Nate-Asmare/Quadruple-robot-build-and-design/images/hardware/IMG_2756.JPG

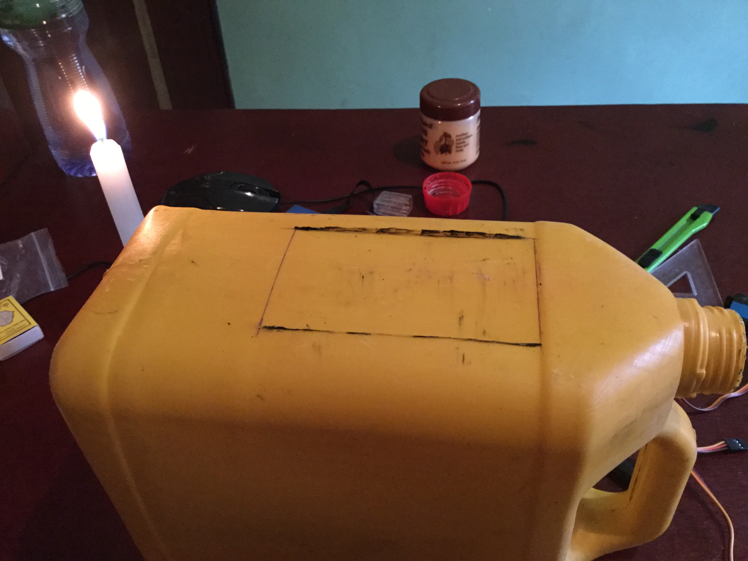
images/hardware/IMG_2756.JPG
