Nate-Asmare/Quadruple-robot-build-and-design/images/ado/Untitled-1.png

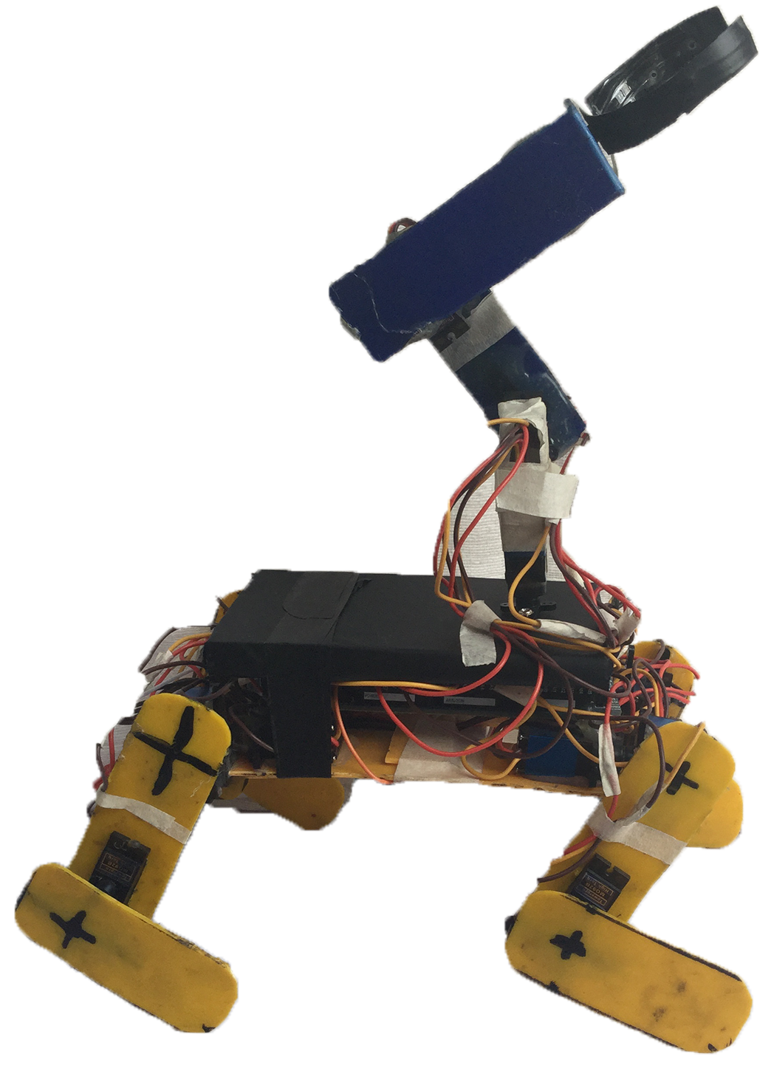
images/ado/Untitled-1.png
