Nate-Asmare/Quadruple-robot-build-and-design/images/design/photo_2020-02-02_10-24-55.jpg

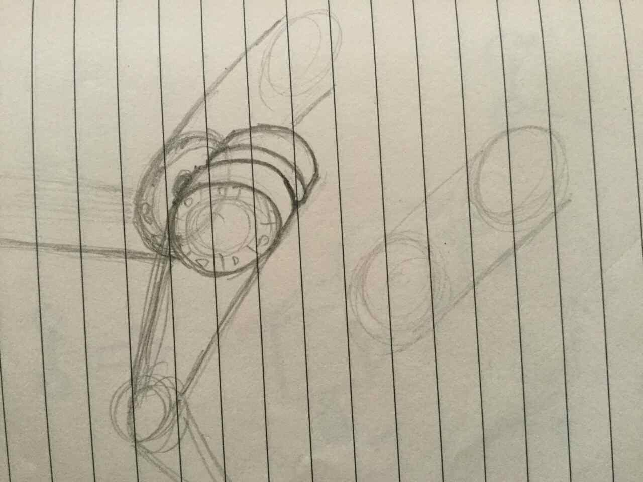
images/design/photo_2020-02-02_10-24-55.jpg
