Nate-Asmare/Quadruple-robot-build-and-design/images/design/photo_2020-02-02_10-25-00.jpg

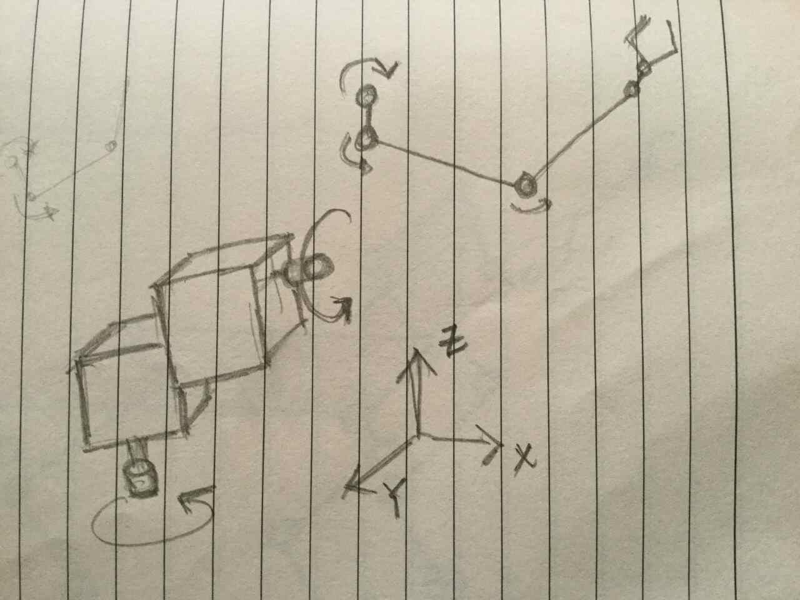
images/design/photo_2020-02-02_10-25-00.jpg
