Nate-Asmare/Quadruple-robot-build-and-design/images/diagrams and sketches/22.png

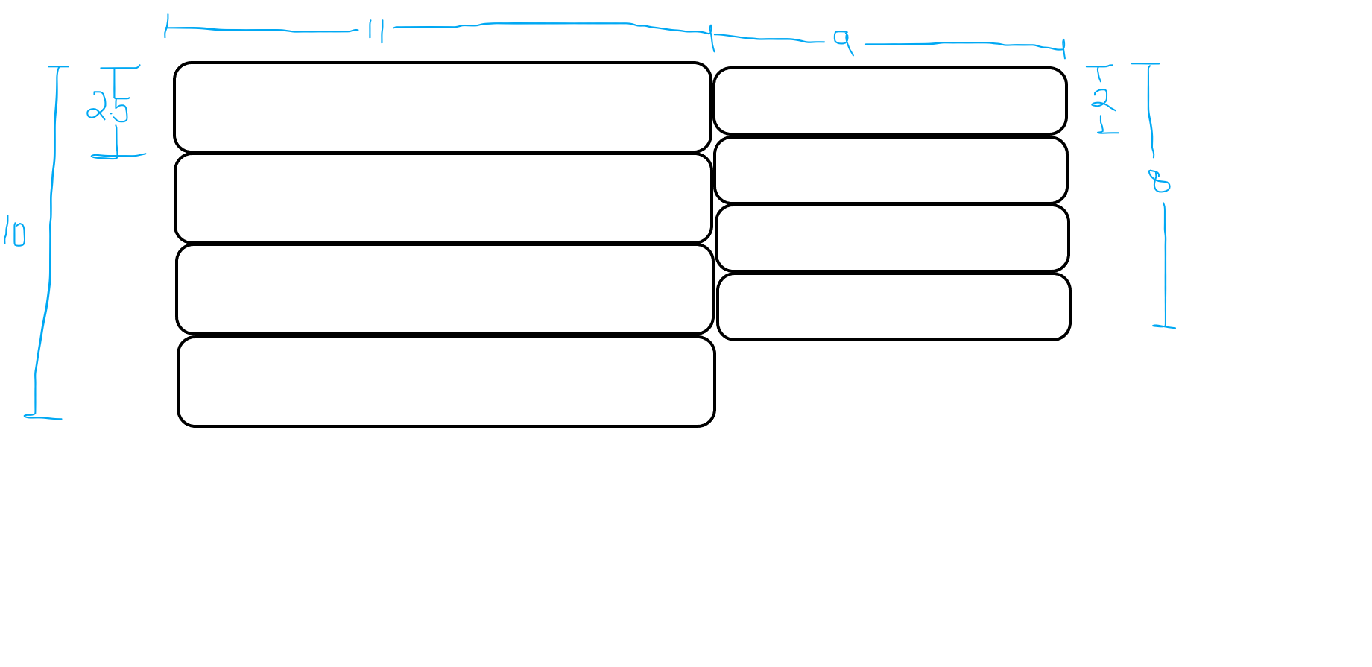
images/diagrams and sketches/22.png
