Nate-Asmare/Quadruple-robot-build-and-design/images/diagrams and sketches/arm bare model.png

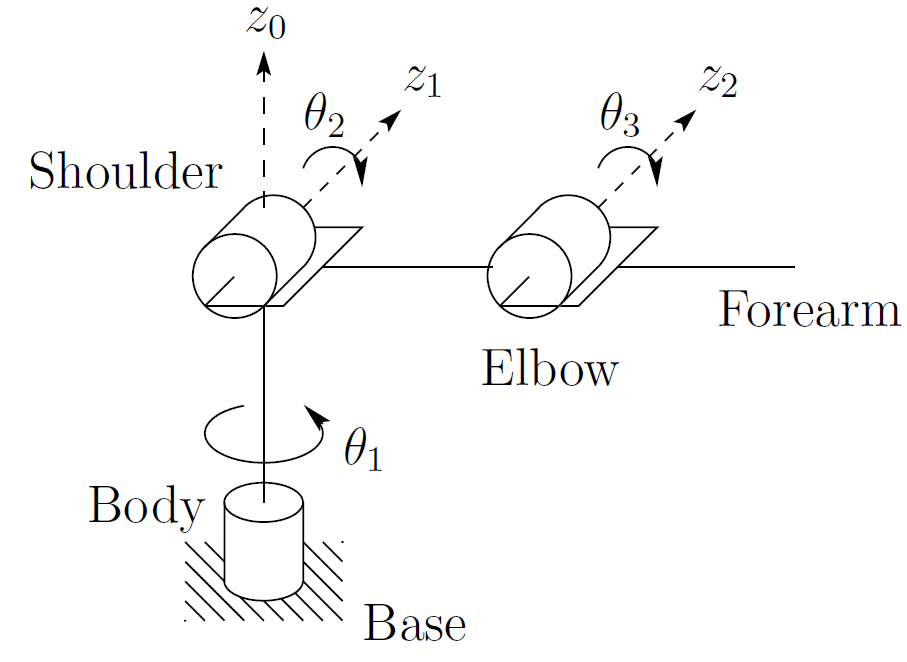
images/diagrams and sketches/arm bare model.png
