Nate-Asmare/Quadruple-robot-build-and-design/images/diagrams and sketches/arm dimentions2.png

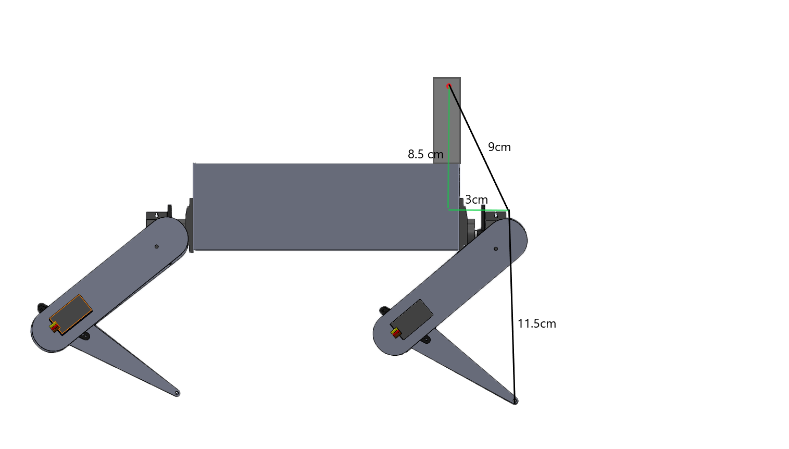
images/diagrams and sketches/arm dimentions2.png
