Nate-Asmare/Quadruple-robot-build-and-design/images/diagrams and sketches/arm dimentions.png

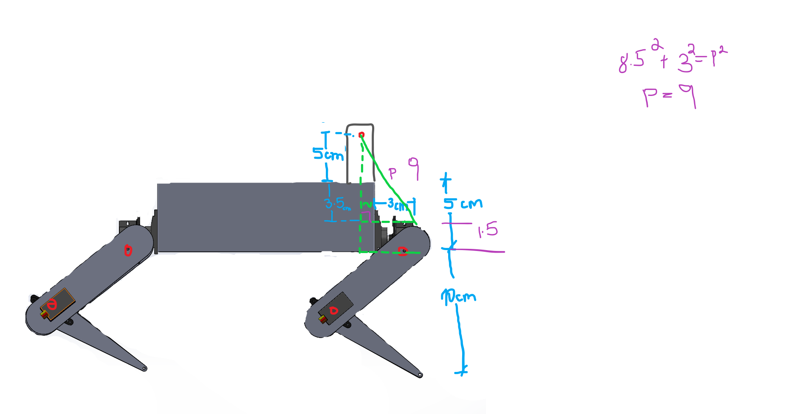
images/diagrams and sketches/arm dimentions.png
