Nate-Asmare/Quadruple-robot-build-and-design/images/diagrams and sketches/big quadrupled locomotive.png

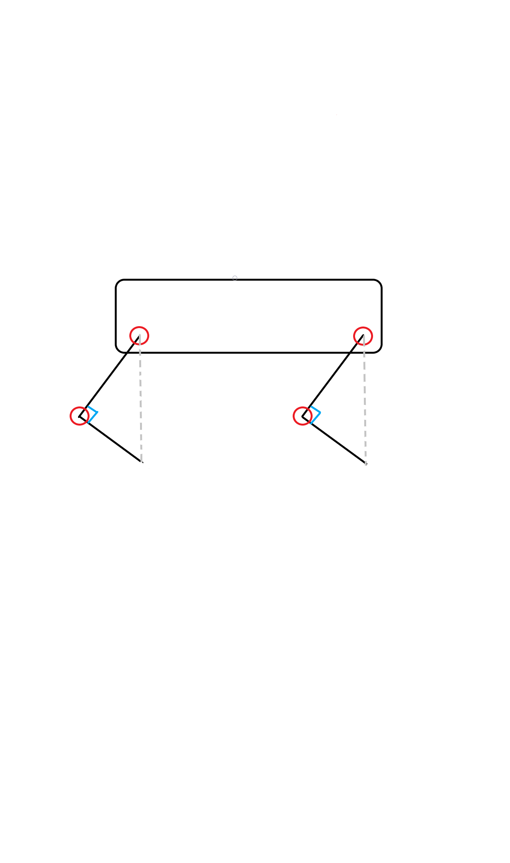
images/diagrams and sketches/big quadrupled locomotive.png
