Nate-Asmare/Quadruple-robot-build-and-design/images/diagrams and sketches/controler design.png

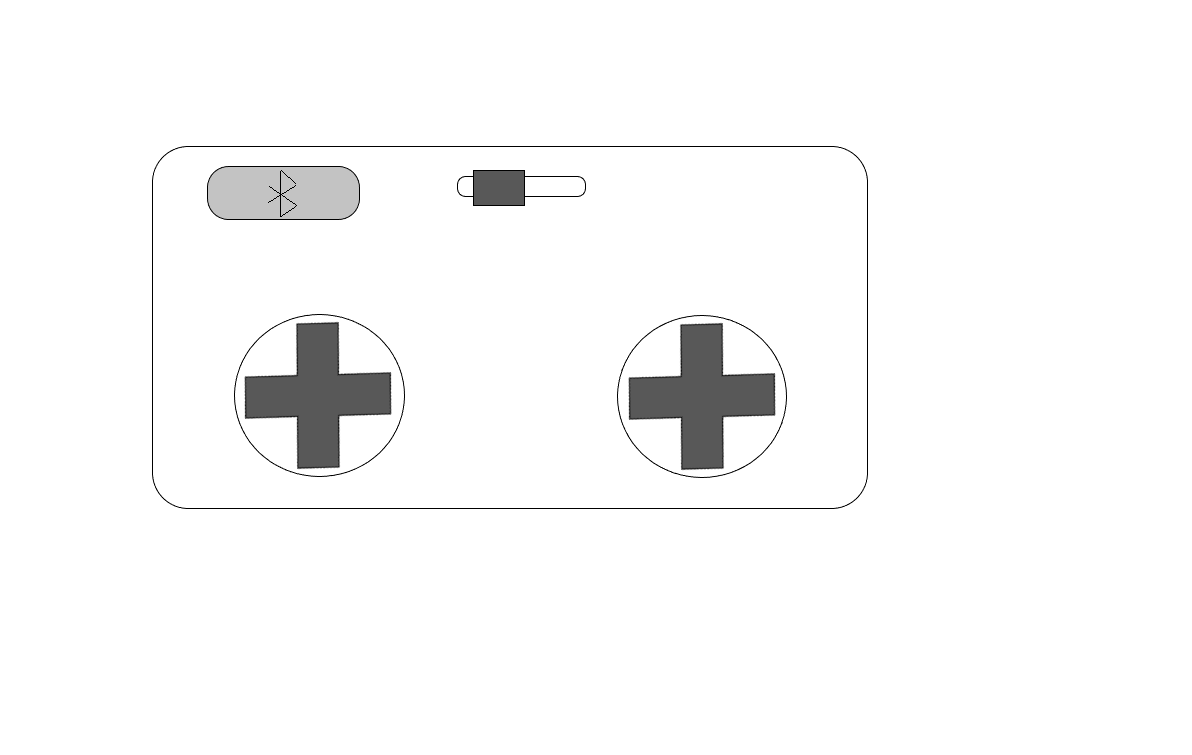
images/diagrams and sketches/controler design.png
