Nate-Asmare/Quadruple-robot-build-and-design/images/diagrams and sketches/cup.png

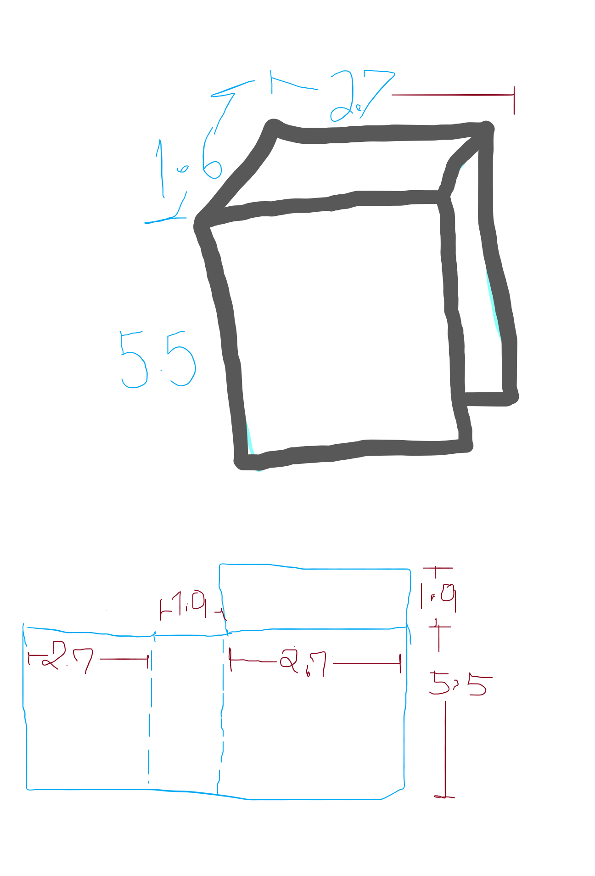
images/diagrams and sketches/cup.png
