Nate-Asmare/Quadruple-robot-build-and-design/images/diagrams and sketches/elbow down final.png

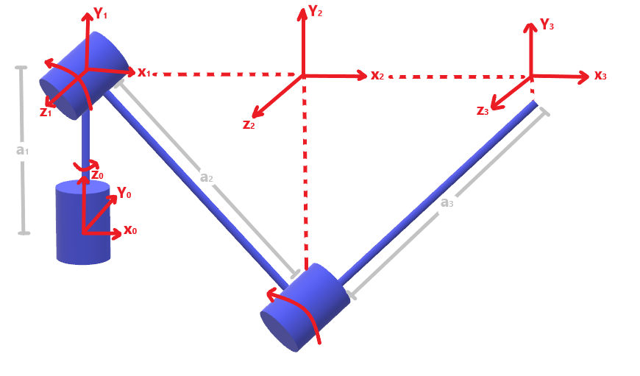
images/diagrams and sketches/elbow down final.png
