Nate-Asmare/Quadruple-robot-build-and-design/images/diagrams and sketches/elbow down.PNG

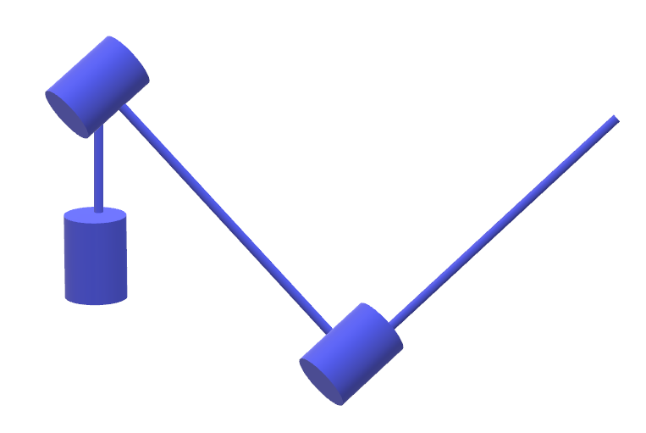
images/diagrams and sketches/elbow down.PNG
