Nate-Asmare/Quadruple-robot-build-and-design/images/diagrams and sketches/end effector.png

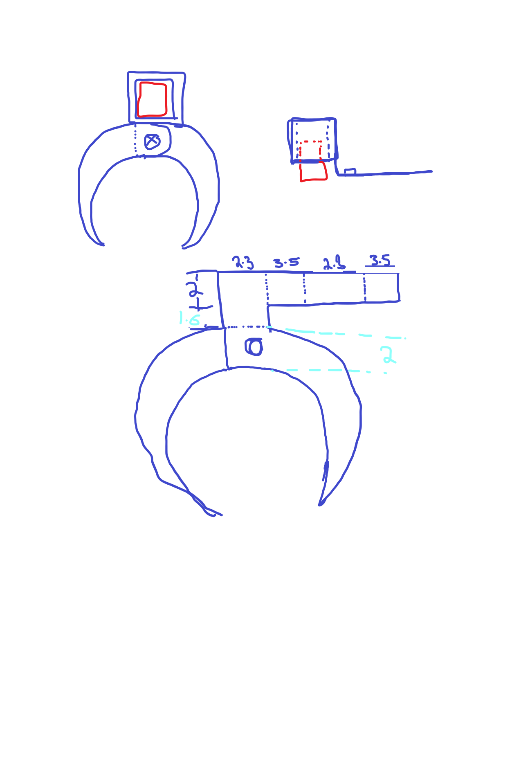
images/diagrams and sketches/end effector.png
