Nate-Asmare/Quadruple-robot-build-and-design/images/diagrams and sketches/flat on ground.png

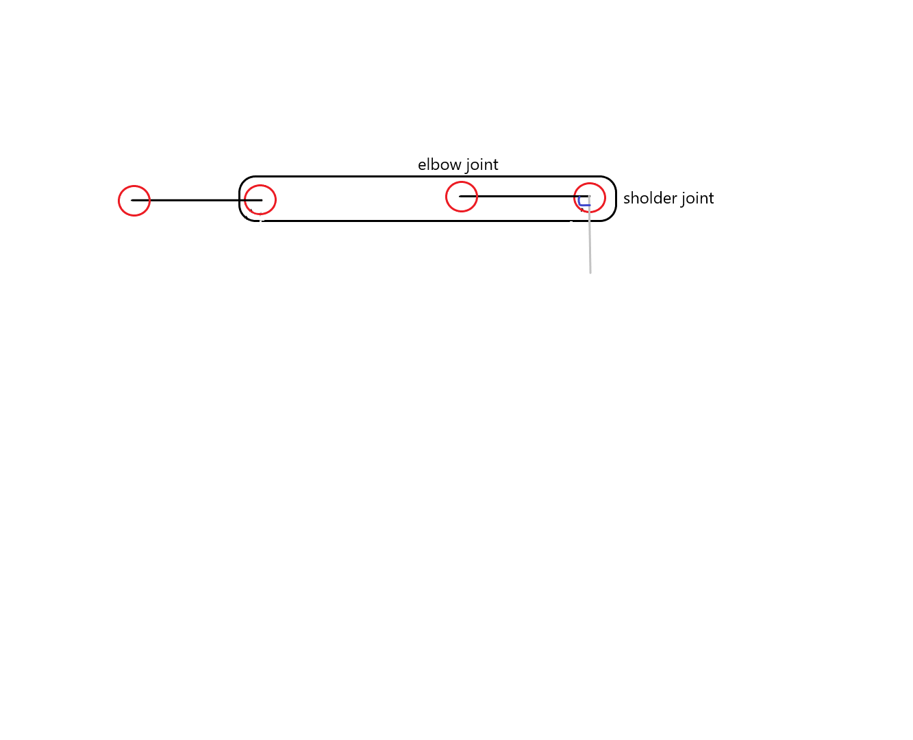
images/diagrams and sketches/flat on ground.png
