Nate-Asmare/Quadruple-robot-build-and-design/images/diagrams and sketches/for torque calculation.png

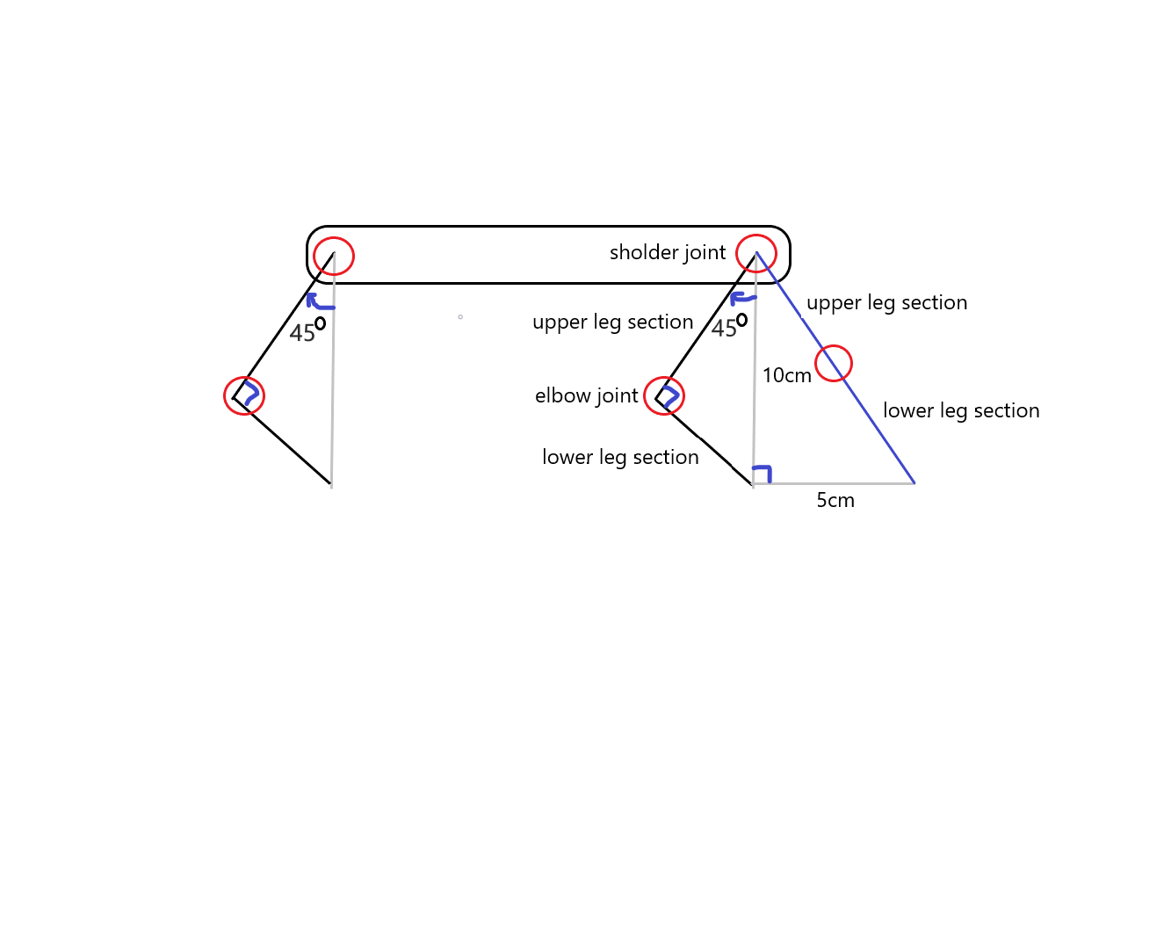
images/diagrams and sketches/for torque calculation.png
