Nate-Asmare/Quadruple-robot-build-and-design/images/diagrams and sketches/going stright gait.png

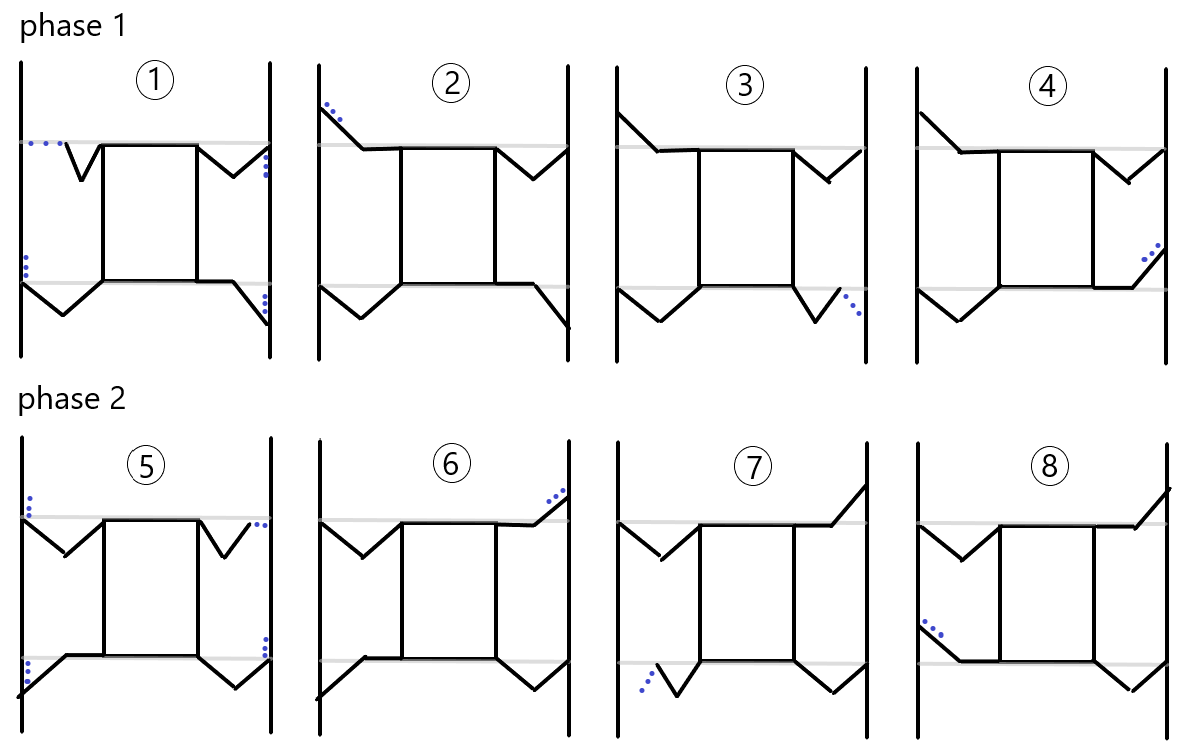
images/diagrams and sketches/going stright gait.png
