Nate-Asmare/Quadruple-robot-build-and-design/images/diagrams and sketches/kinematic model for quadruple locomotive.png

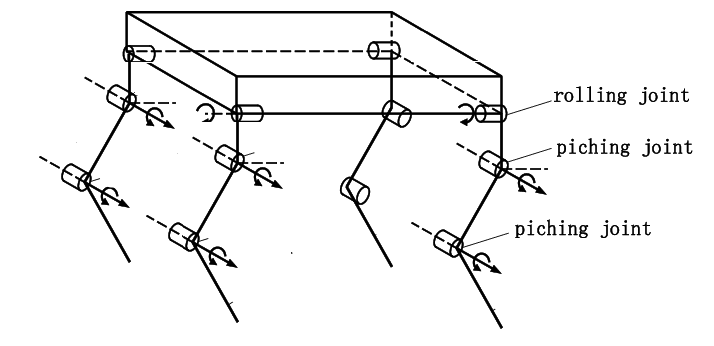
images/diagrams and sketches/kinematic model for quadruple locomotive.png
