Nate-Asmare/Quadruple-robot-build-and-design/images/diagrams and sketches/leg design sketch.png

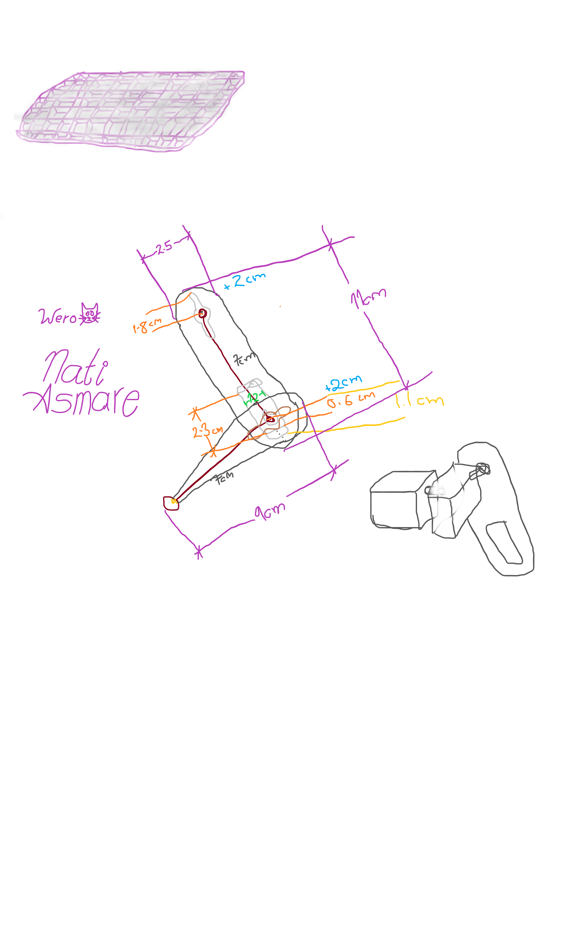
images/diagrams and sketches/leg design sketch.png
