Nate-Asmare/Quadruple-robot-build-and-design/images/diagrams and sketches/leg section calculation.png

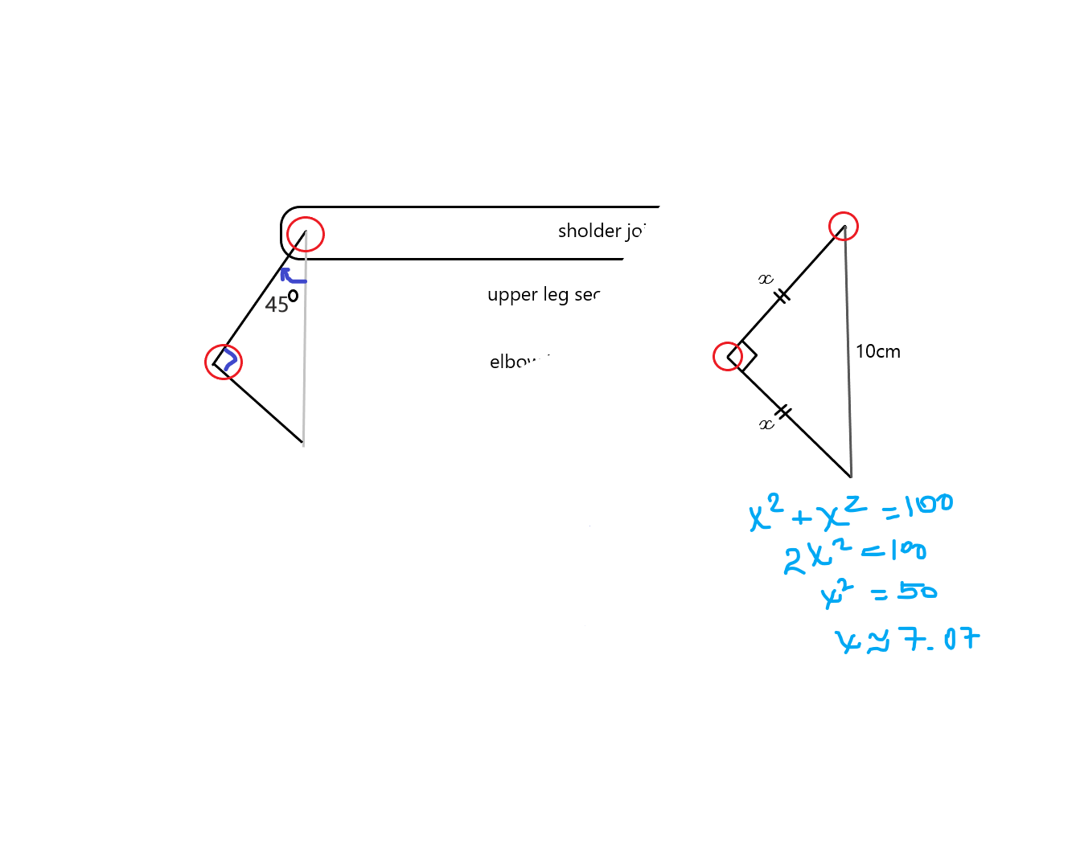
images/diagrams and sketches/leg section calculation.png
