Nate-Asmare/Quadruple-robot-build-and-design/images/diagrams and sketches/Maximum hight form of quadrupled robot.png

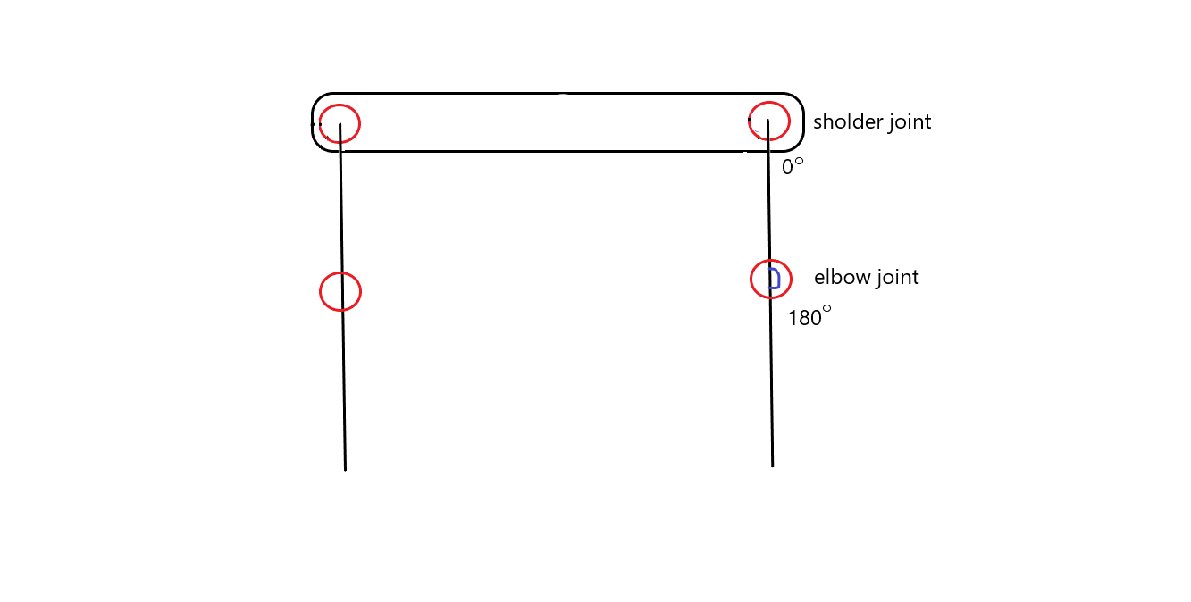
images/diagrams and sketches/Maximum hight form of quadrupled robot.png
