Nate-Asmare/Quadruple-robot-build-and-design/images/diagrams and sketches/quadrupled locomotive default form sketch 1.png

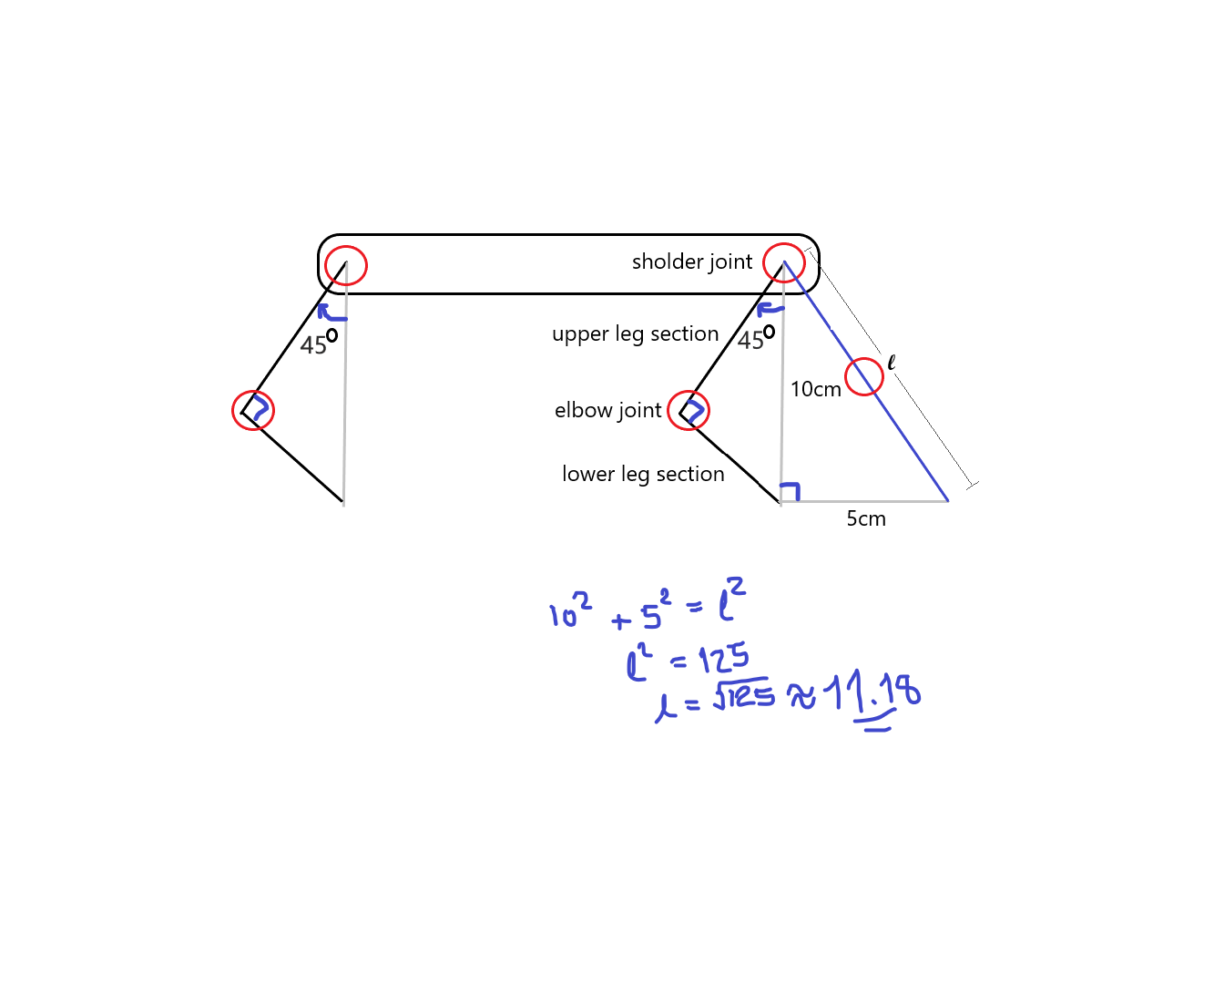
images/diagrams and sketches/quadrupled locomotive default form sketch 1.png
