Nate-Asmare/Quadruple-robot-build-and-design/images/diagrams and sketches/quadrupled locomotive side view.PNG

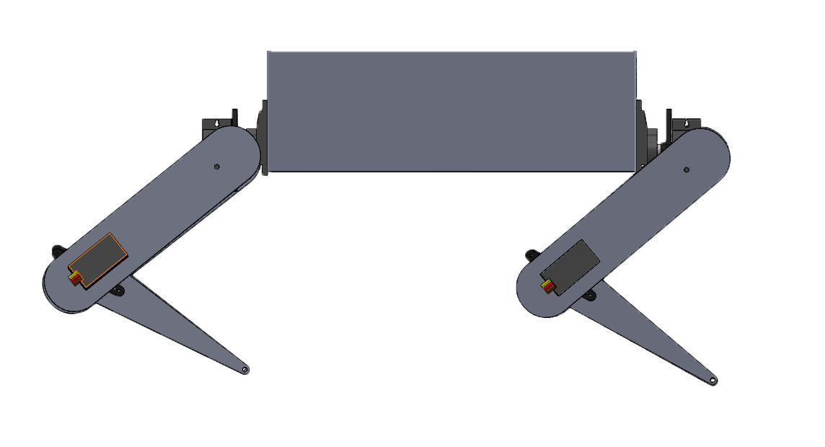
images/diagrams and sketches/quadrupled locomotive side view.PNG
