Nate-Asmare/Quadruple-robot-build-and-design/images/diagrams and sketches/top and side kenimatic view elbow up.png

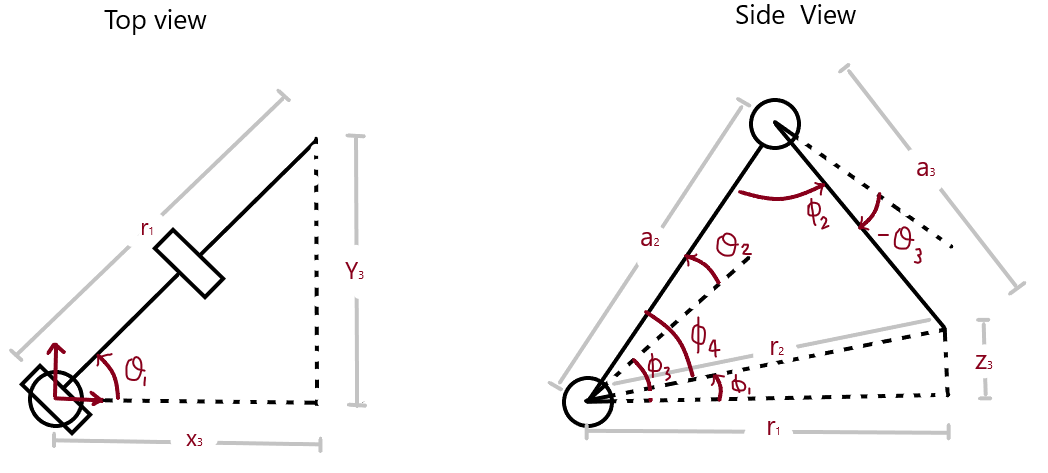
images/diagrams and sketches/top and side kenimatic view elbow up.png
