Nate-Asmare/Quadruple-robot-build-and-design/images/diagrams and sketches/torque calculation model.png

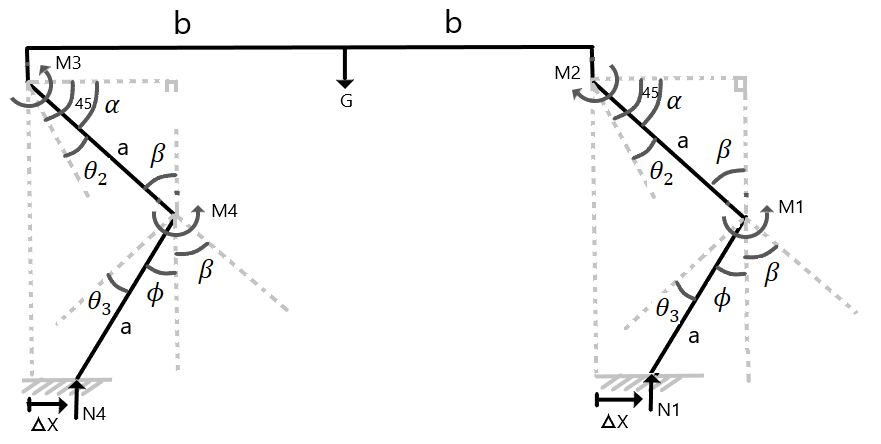
images/diagrams and sketches/torque calculation model.png
