Nate-Asmare/Quadruple-robot-build-and-design/images/diagrams and sketches/turning base.png

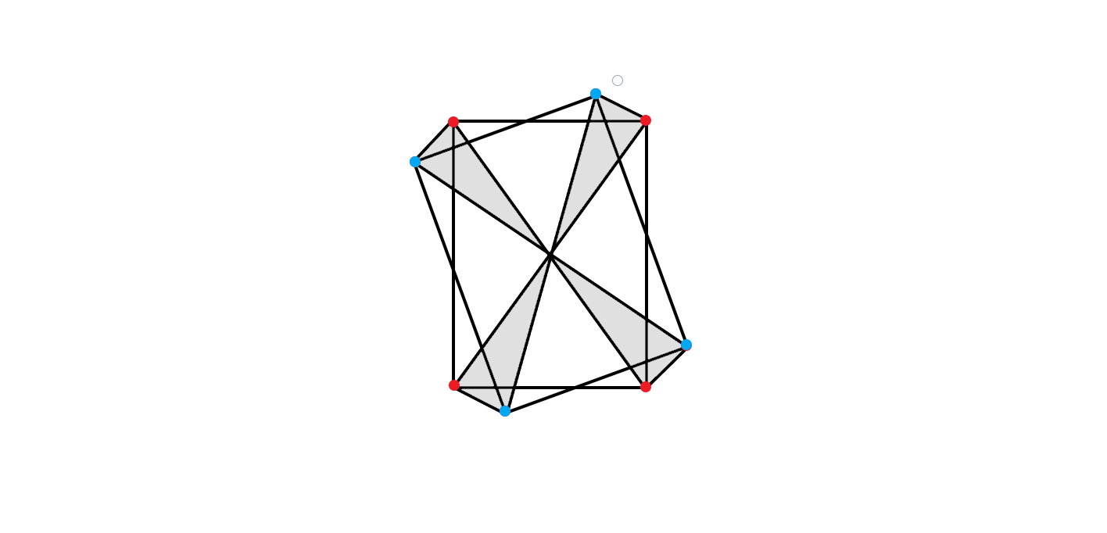
images/diagrams and sketches/turning base.png
