Nate-Asmare/Quadruple-robot-build-and-design/images/diagrams and sketches/turning gait model.png

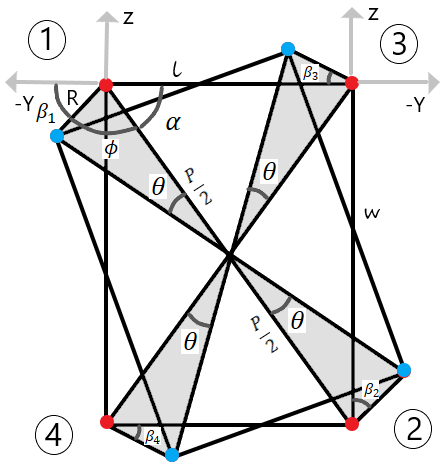
images/diagrams and sketches/turning gait model.png
