Nate-Asmare/Quadruple-robot-build-and-design/images/drawings/9v battery.PNG

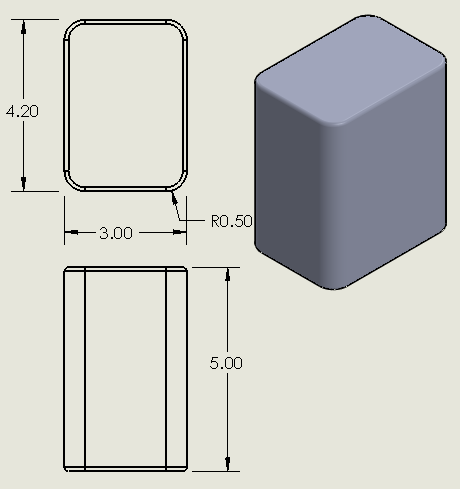
images/drawings/9v battery.PNG
