Nate-Asmare/Quadruple-robot-build-and-design/images/drawings/arduino with sheild.PNG

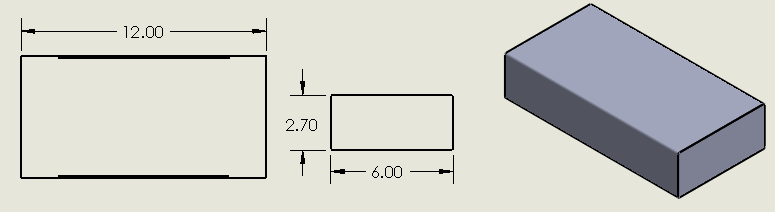
images/drawings/arduino with sheild.PNG
