Nate-Asmare/Quadruple-robot-build-and-design/images/drawings/body enclosure drowing.PNG

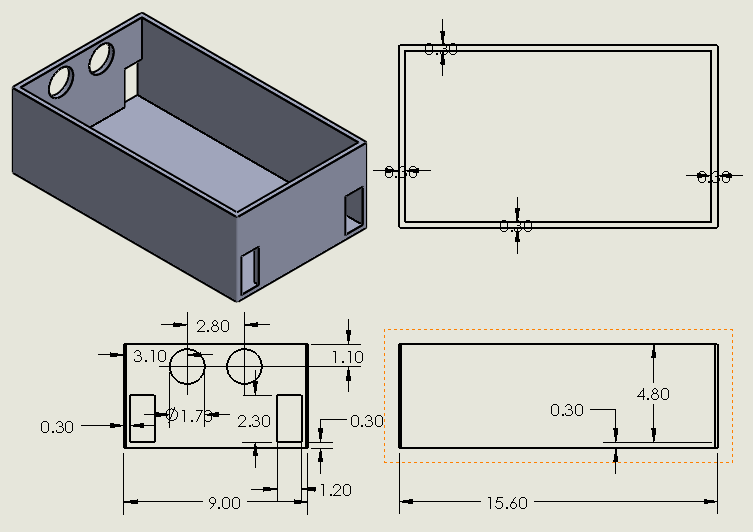
images/drawings/body enclosure drowing.PNG
