Nate-Asmare/Quadruple-robot-build-and-design/images/drawings/lower leg section.PNG

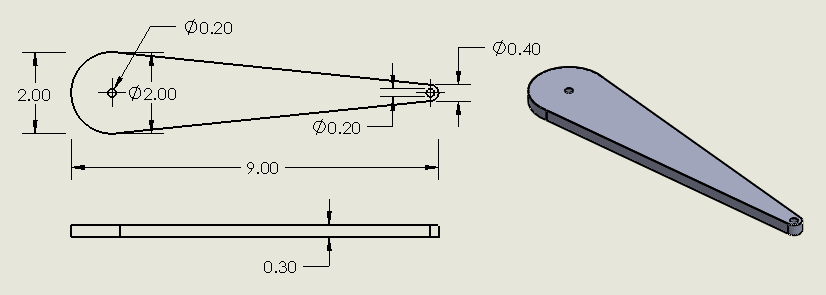
images/drawings/lower leg section.PNG
