Nate-Asmare/Quadruple-robot-build-and-design/images/drawings/quadruple locomotive mode.png

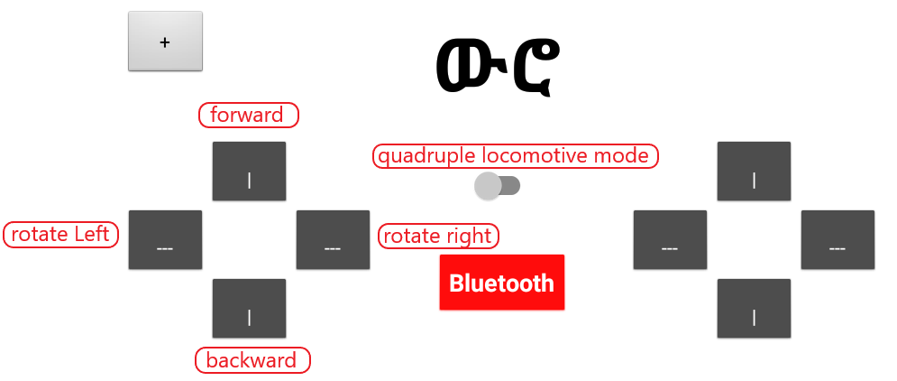
images/drawings/quadruple locomotive mode.png
