Nate-Asmare/Quadruple-robot-build-and-design/images/drawings/quadrupled locomotive 3 view.PNG

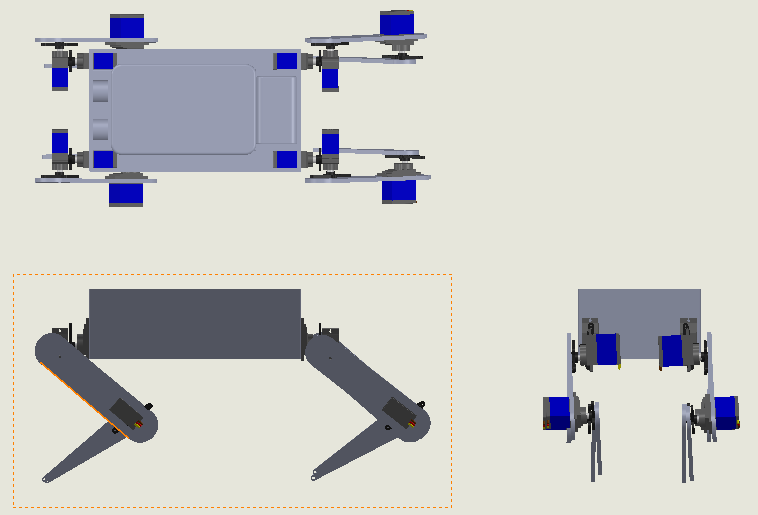
images/drawings/quadrupled locomotive 3 view.PNG
