Nate-Asmare/Quadruple-robot-build-and-design/images/drawings/quadrupled locomotive hight.PNG

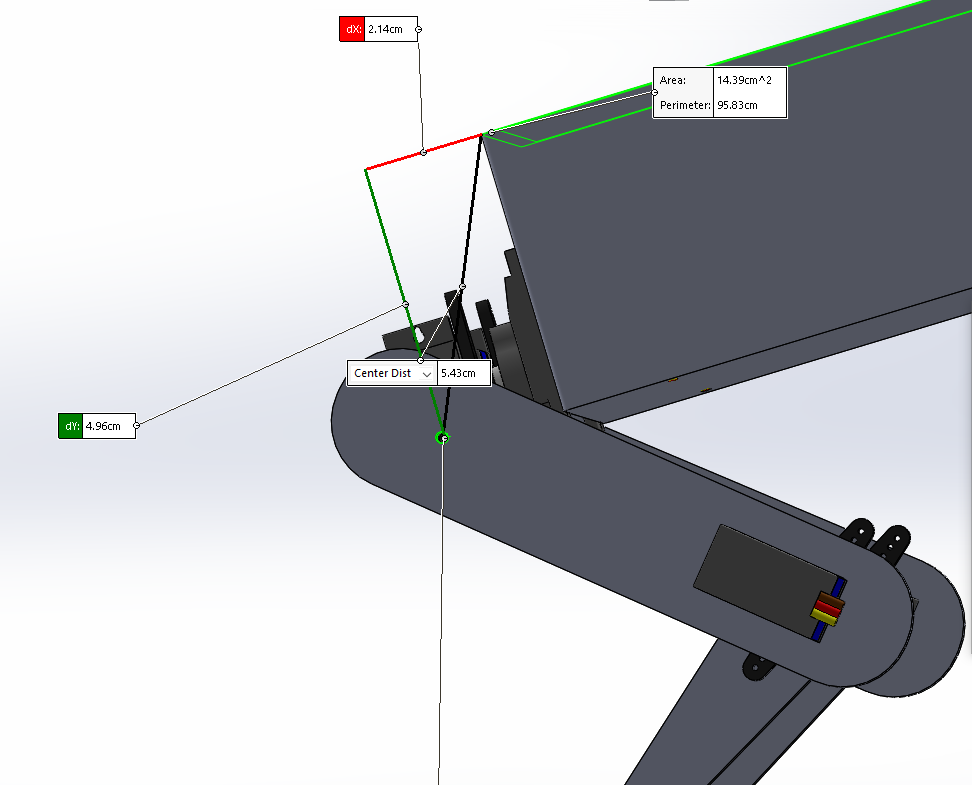
images/drawings/quadrupled locomotive hight.PNG
