Nate-Asmare/Quadruple-robot-build-and-design/images/drawings/quadrupled locomotive.PNG

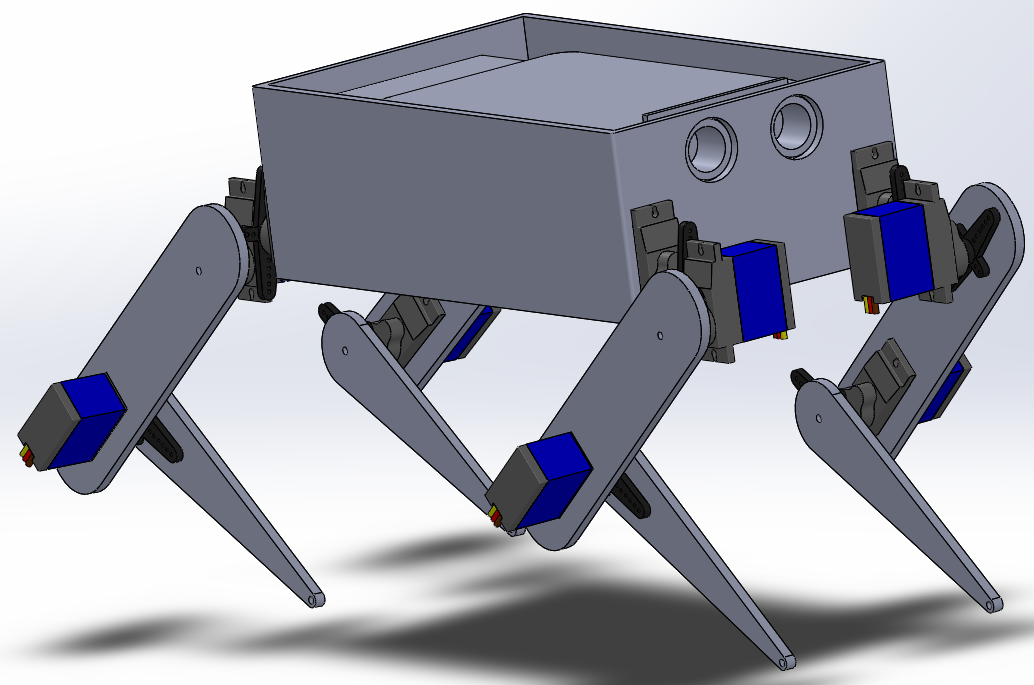
images/drawings/quadrupled locomotive.PNG
