Nate-Asmare/Quadruple-robot-build-and-design/images/drawings/robotic arm control.png

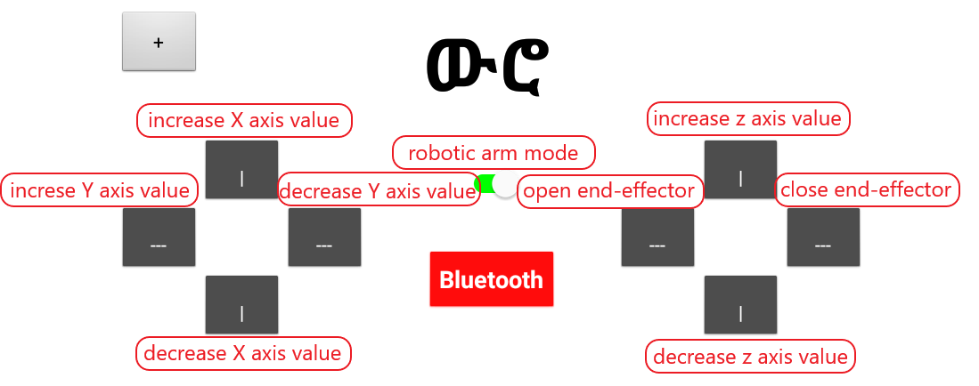
images/drawings/robotic arm control.png
