Nate-Asmare/Quadruple-robot-build-and-design/images/drawings/ultrasonic sensor.PNG

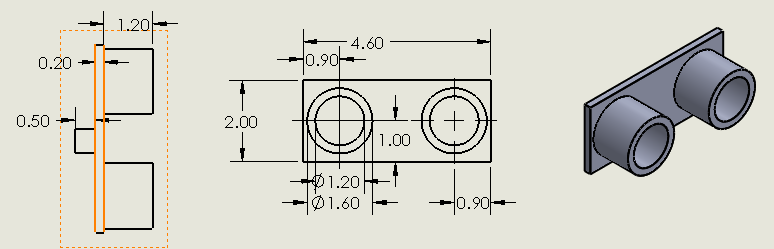
images/drawings/ultrasonic sensor.PNG
