Nate-Asmare/Quadruple-robot-build-and-design/images/drawings/upper leg section.PNG

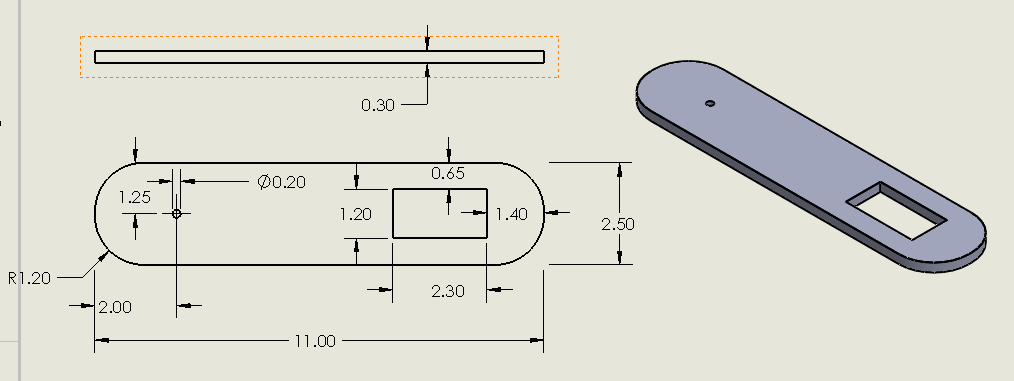
images/drawings/upper leg section.PNG
