Nate-Asmare/Quadruple-robot-build-and-design/images/drawings/workspace of arm.PNG

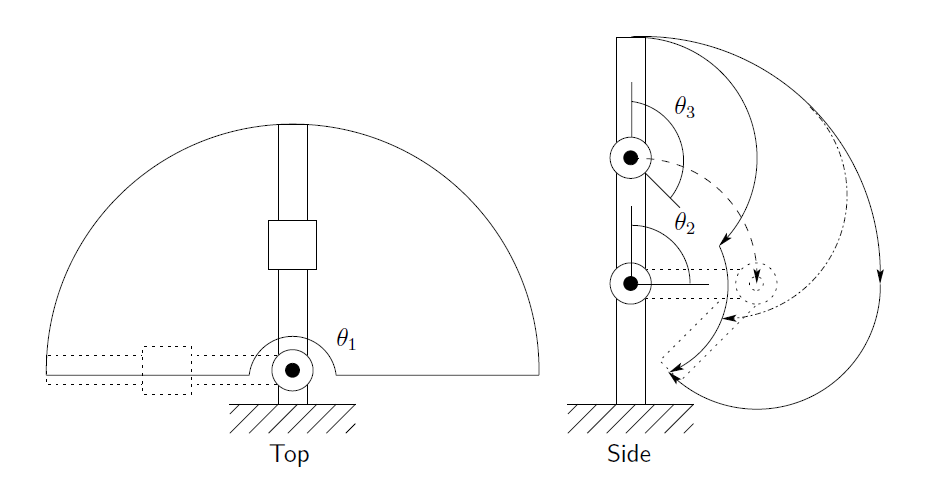
images/drawings/workspace of arm.PNG
