Nate-Asmare/Quadruple-robot-build-and-design/images/for kinematics/The-Schematic-Diagram-of-the-Quadruped-Robot.png

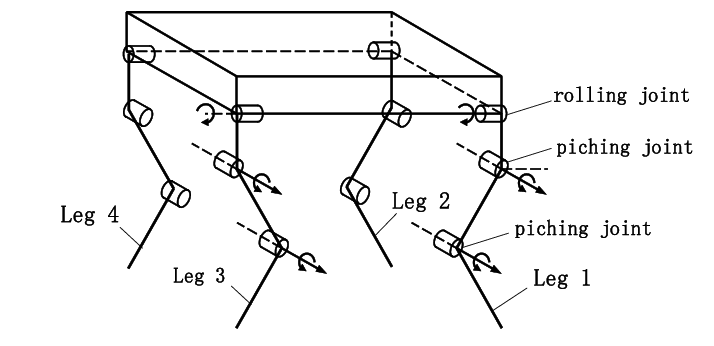
images/for kinematics/The-Schematic-Diagram-of-the-Quadruped-Robot.png
