Nate-Asmare/Quadruple-robot-build-and-design/images/hardware/IMG_2757.JPG

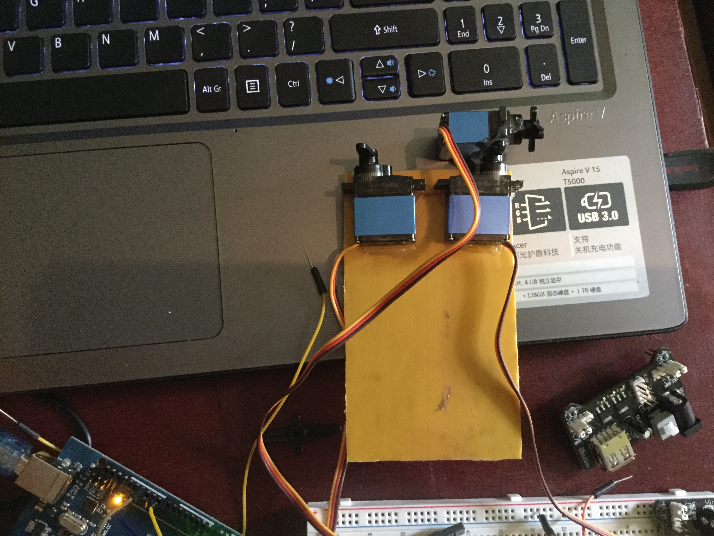
images/hardware/IMG_2757.JPG
