Nate-Asmare/Quadruple-robot-build-and-design/images/hardware/IMG_2758.JPG

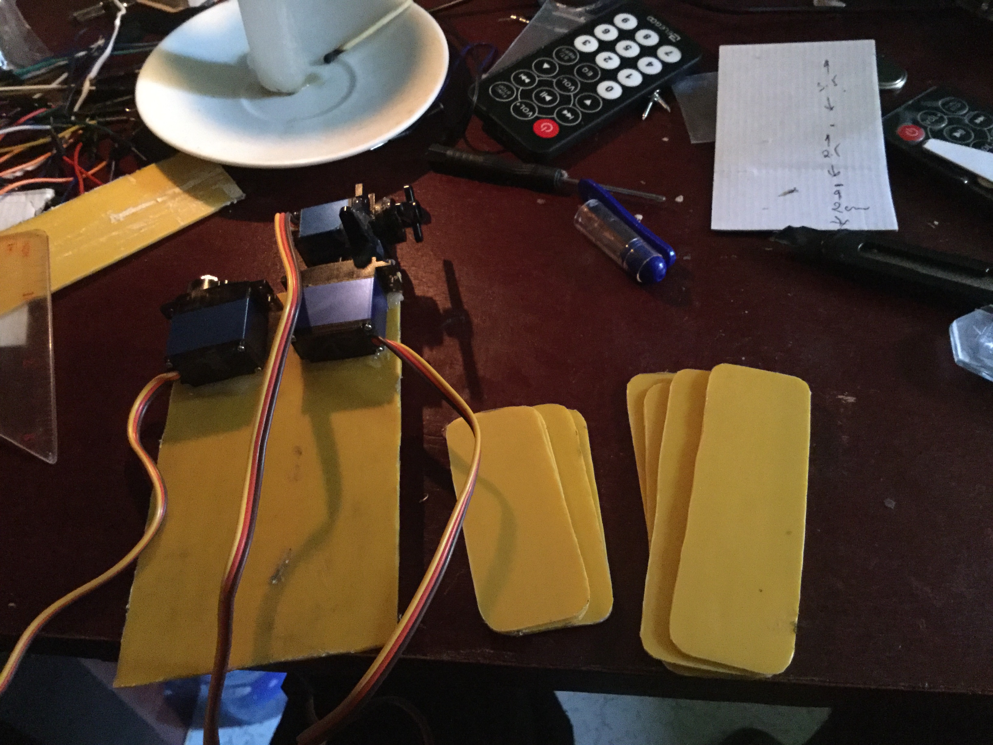
images/hardware/IMG_2758.JPG
