Nate-Asmare/Quadruple-robot-build-and-design/images/hardware/IMG_2759.JPG

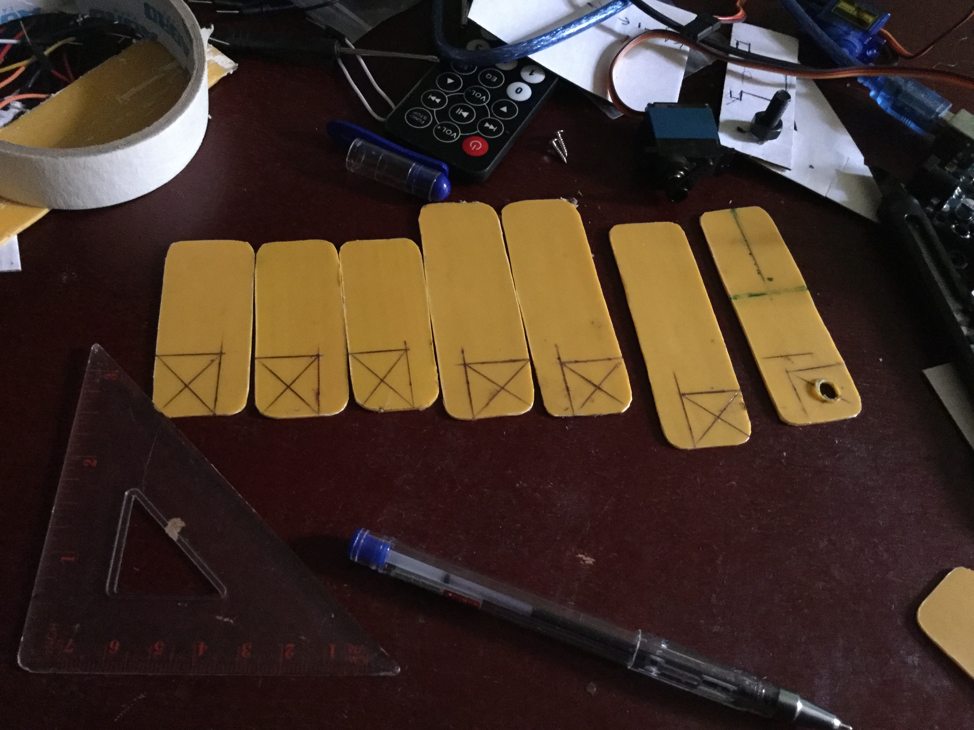
images/hardware/IMG_2759.JPG
