Nate-Asmare/Quadruple-robot-build-and-design/images/hardware/IMG_2760.JPG

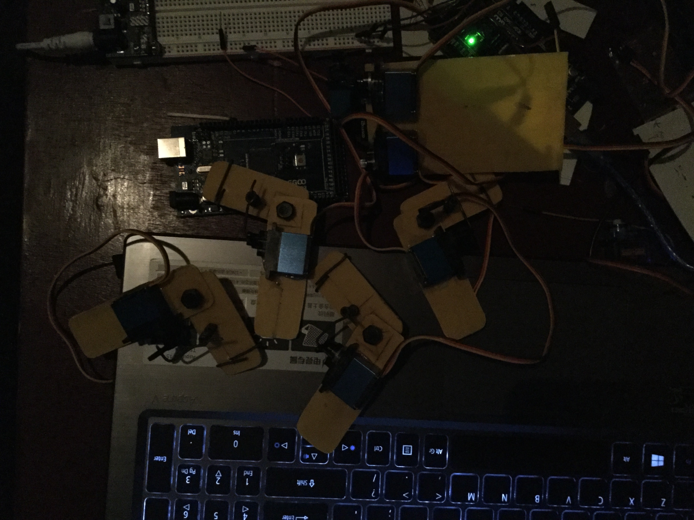
images/hardware/IMG_2760.JPG
