Nate-Asmare/Quadruple-robot-build-and-design/images/hardware/IMG_2761.JPG

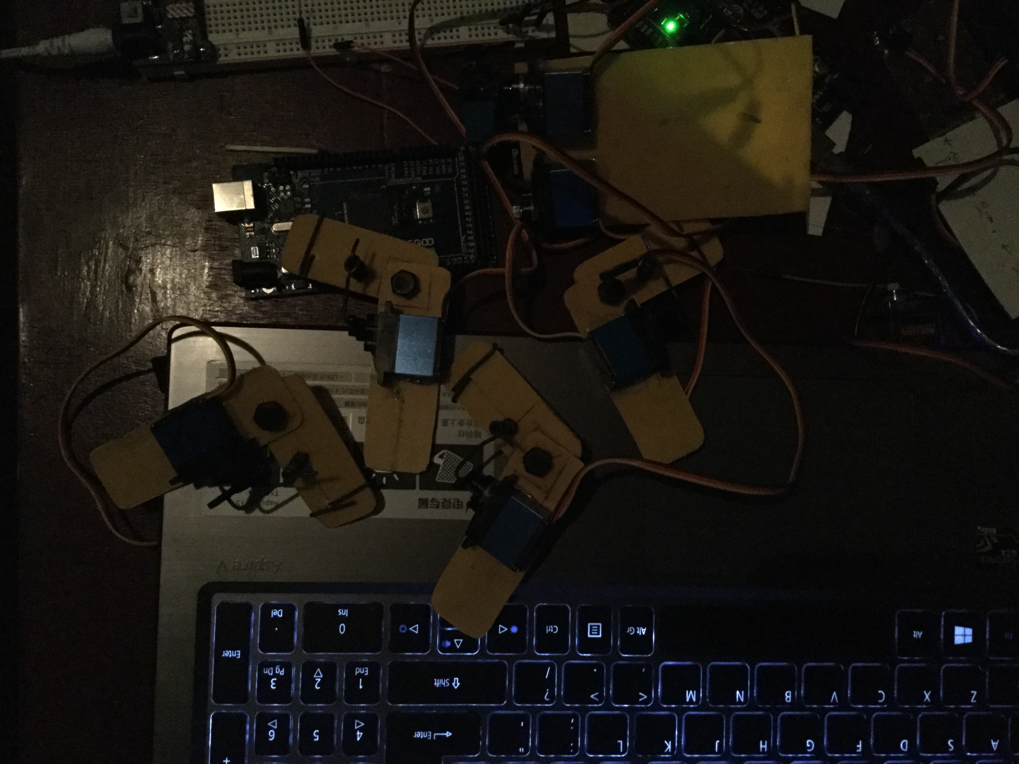
images/hardware/IMG_2761.JPG
