Nate-Asmare/Quadruple-robot-build-and-design/images/hardware/IMG_2762.JPG

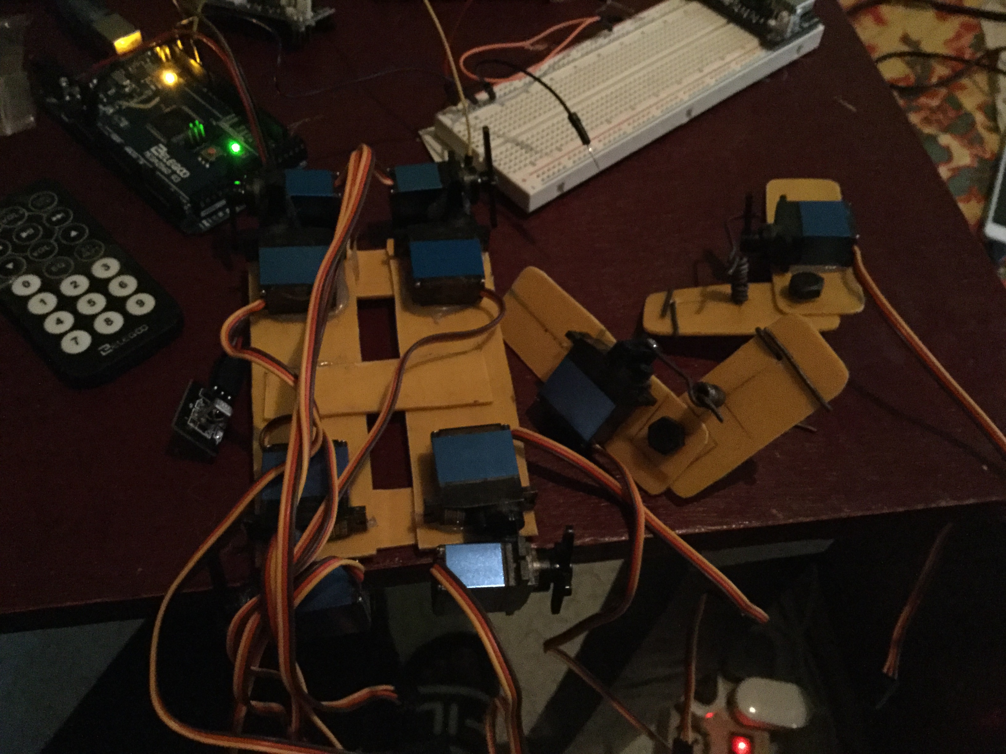
images/hardware/IMG_2762.JPG
