Nate-Asmare/Quadruple-robot-build-and-design/images/hardware/IMG_2763.JPG

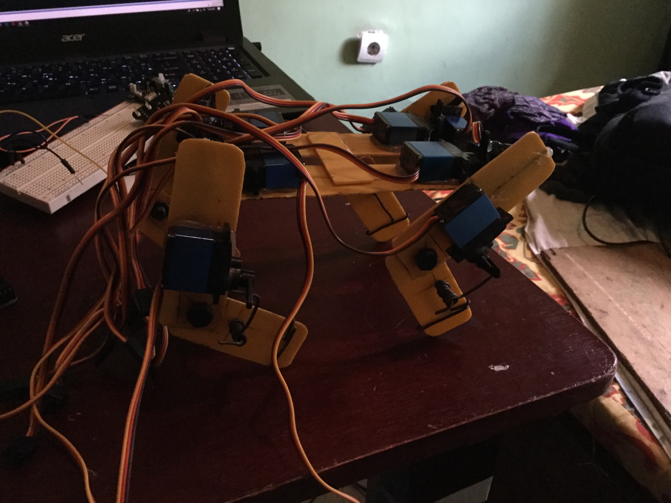
images/hardware/IMG_2763.JPG
