Nate-Asmare/Quadruple-robot-build-and-design/images/hardware/IMG_2765.JPG

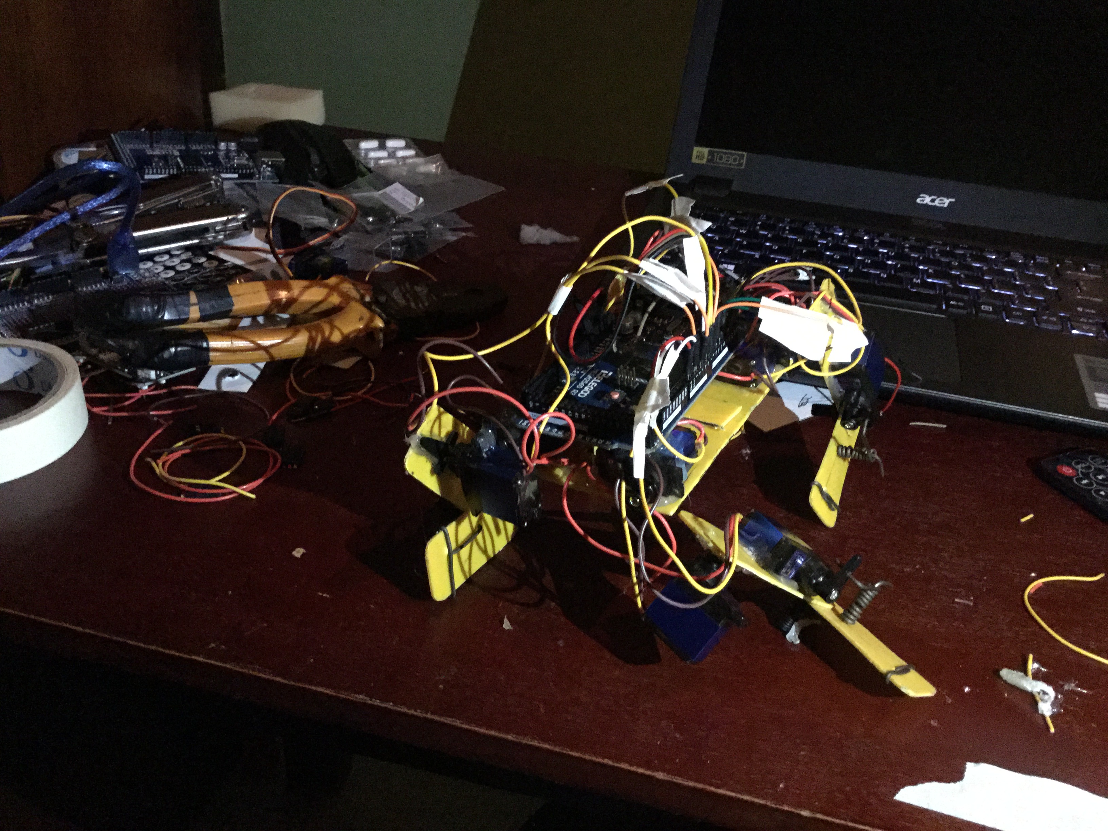
images/hardware/IMG_2765.JPG
