Nate-Asmare/Quadruple-robot-build-and-design/images/hardware/IMG_2768.JPG

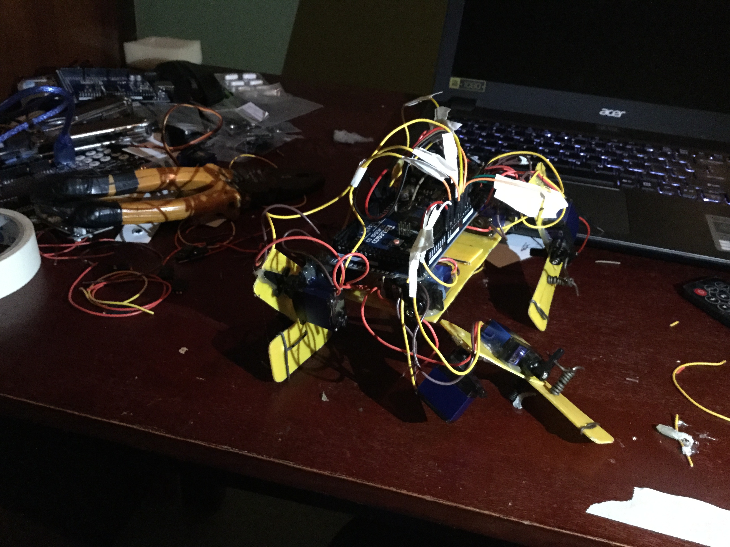
images/hardware/IMG_2768.JPG
