Nate-Asmare/Quadruple-robot-build-and-design/images/hardware/IMG_2770.JPG

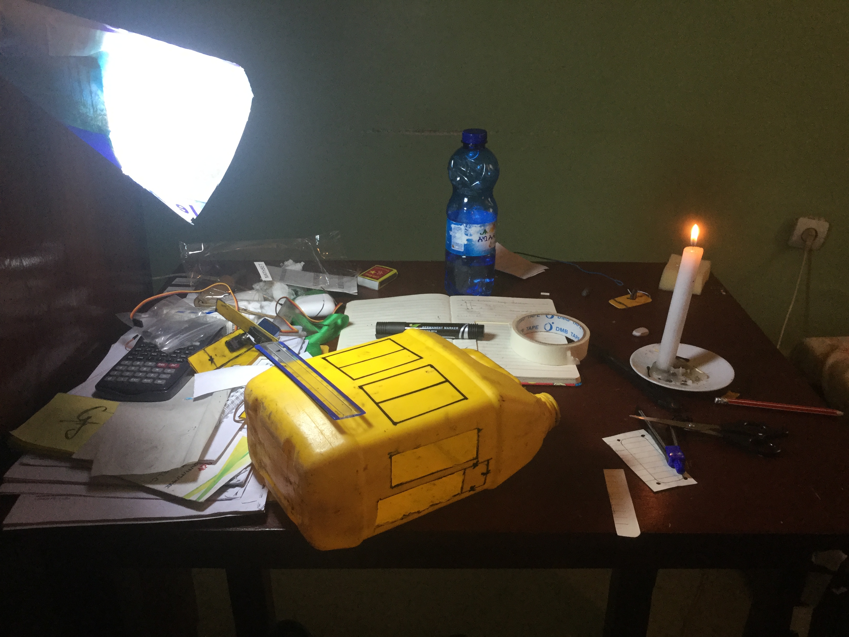
images/hardware/IMG_2770.JPG
