Nate-Asmare/Quadruple-robot-build-and-design/images/hardware/IMG_2771.JPG

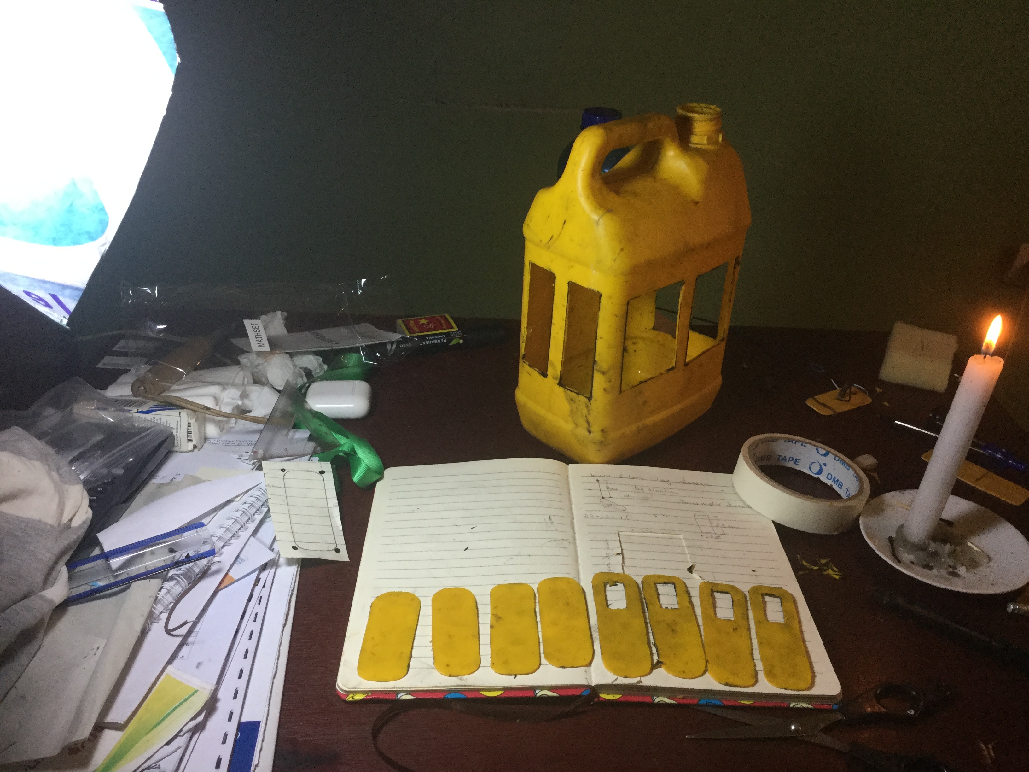
images/hardware/IMG_2771.JPG
