Nate-Asmare/Quadruple-robot-build-and-design/images/hardware/IMG_2856.JPG

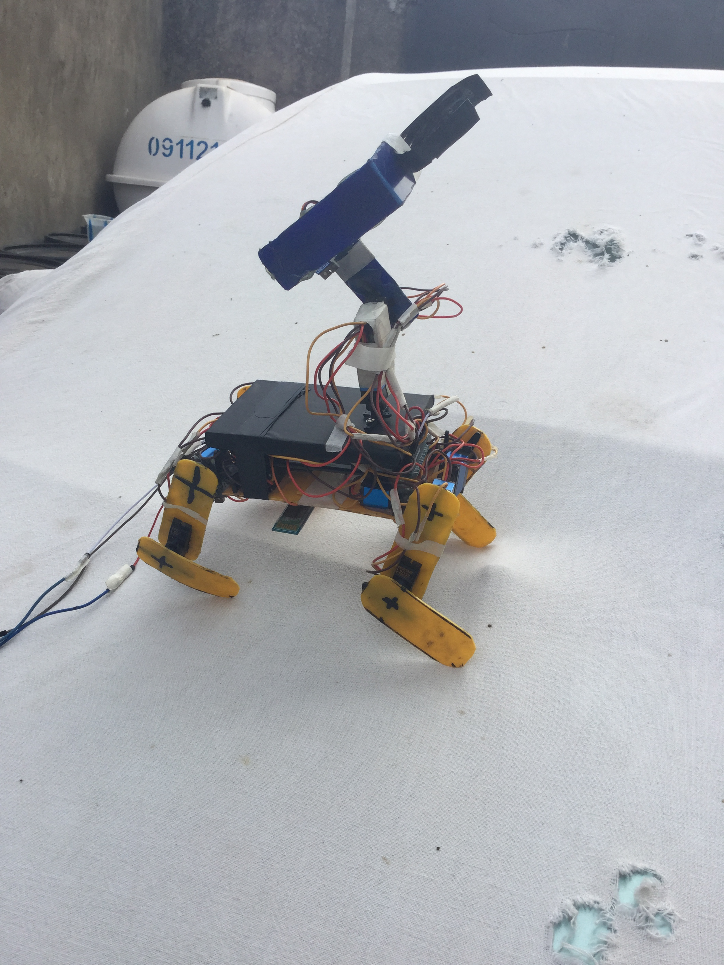
images/hardware/IMG_2856.JPG
