Nate-Asmare/Quadruple-robot-build-and-design/images/hardware/IMG_2857.JPG

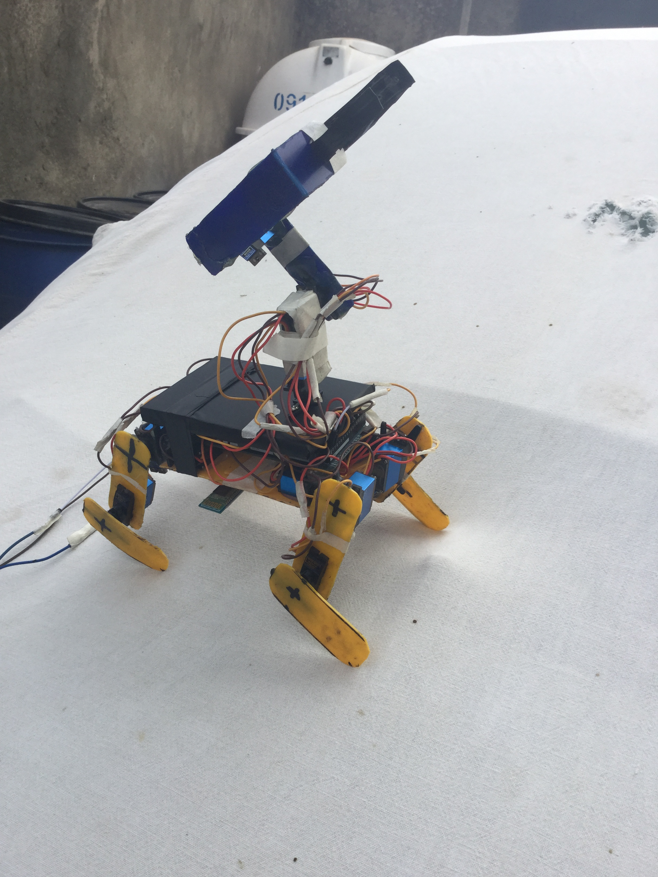
images/hardware/IMG_2857.JPG
