Nate-Asmare/Quadruple-robot-build-and-design/images/hardware/IMG_2858.JPG

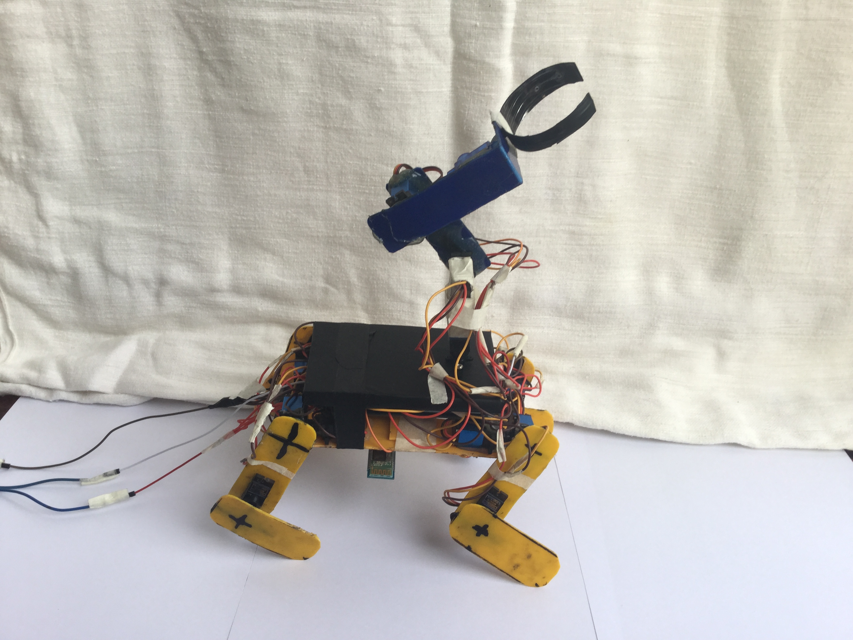
images/hardware/IMG_2858.JPG
