Nate-Asmare/Quadruple-robot-build-and-design/images/hardware/IMG_2859.JPG

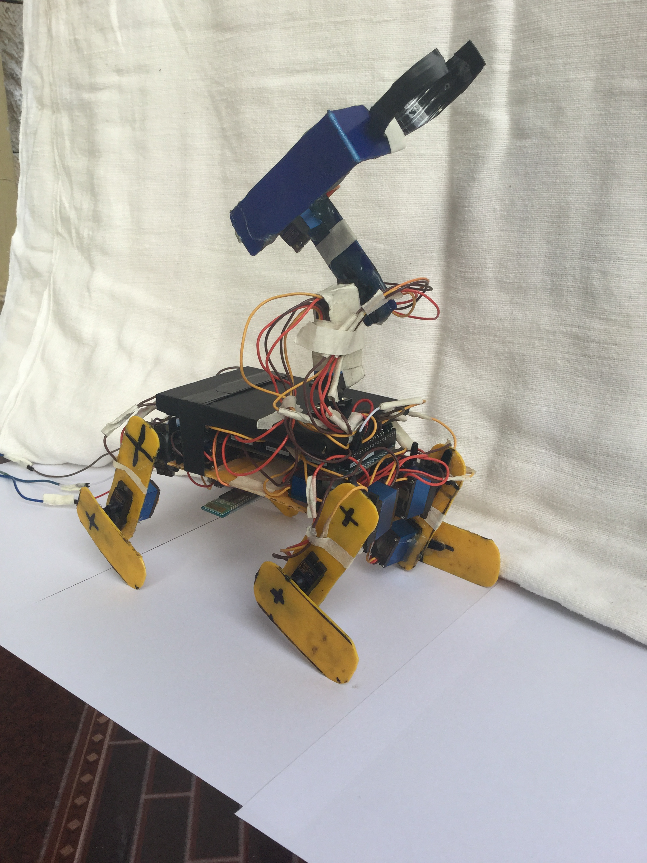
images/hardware/IMG_2859.JPG
