Nate-Asmare/Quadruple-robot-build-and-design/images/hardware/IMG_2860.JPG

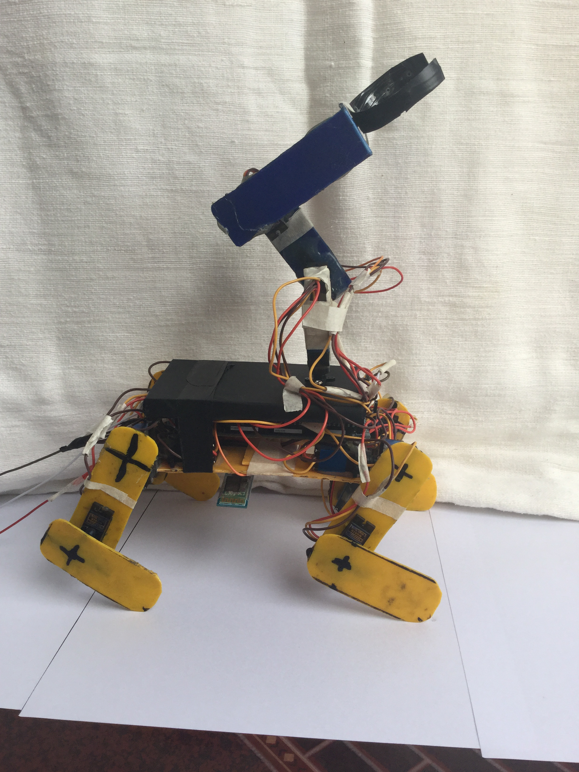
images/hardware/IMG_2860.JPG
