Nate-Asmare/Quadruple-robot-build-and-design/images/photo/IMG_3019.JPG

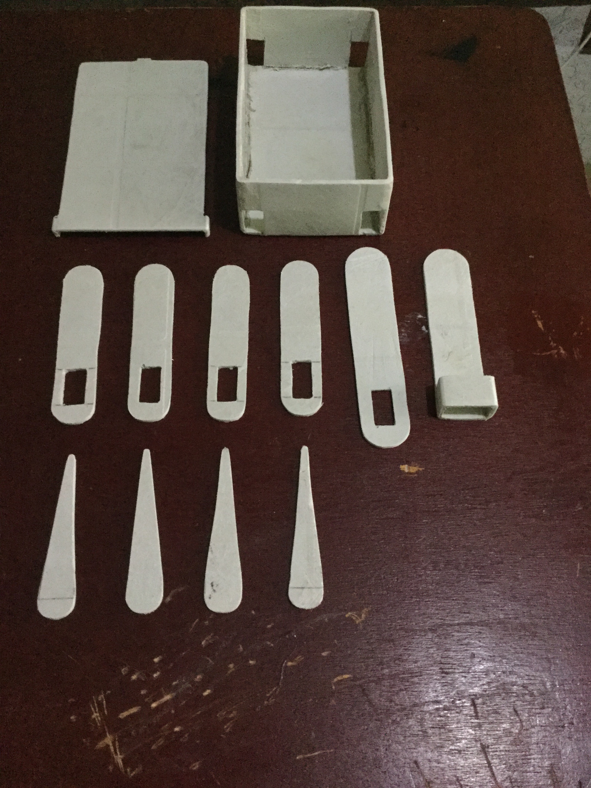
images/photo/IMG_3019.JPG
