Nate-Asmare/Quadruple-robot-build-and-design/images/photo/IMG_3022.JPG

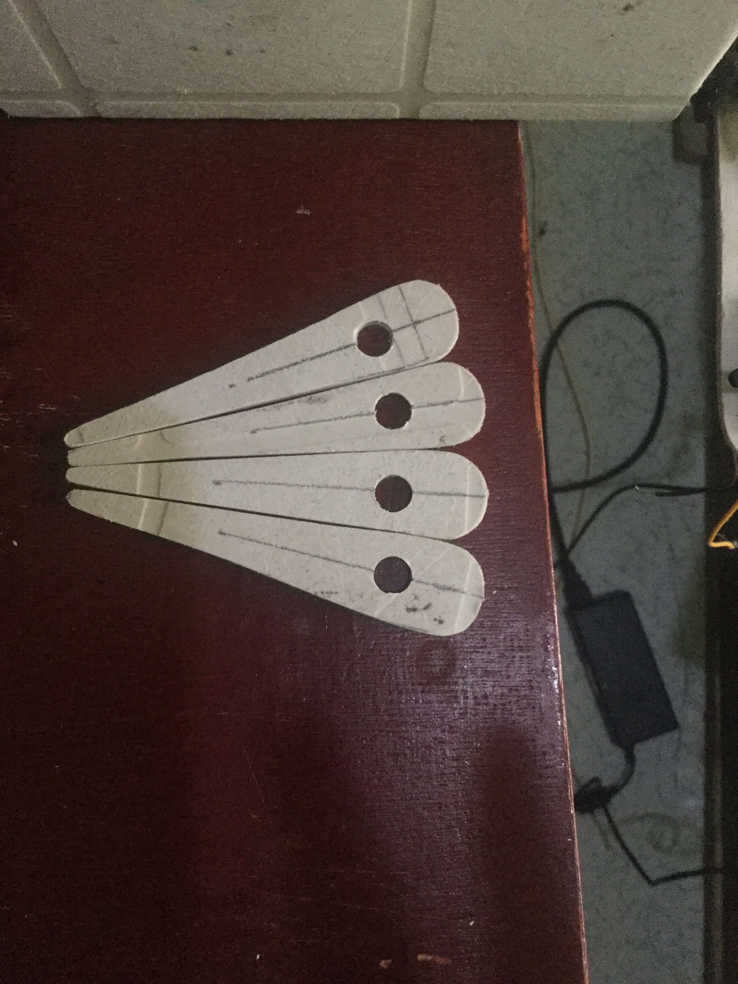
images/photo/IMG_3022.JPG
