Nate-Asmare/Quadruple-robot-build-and-design/images/photo/IMG_3040.JPG

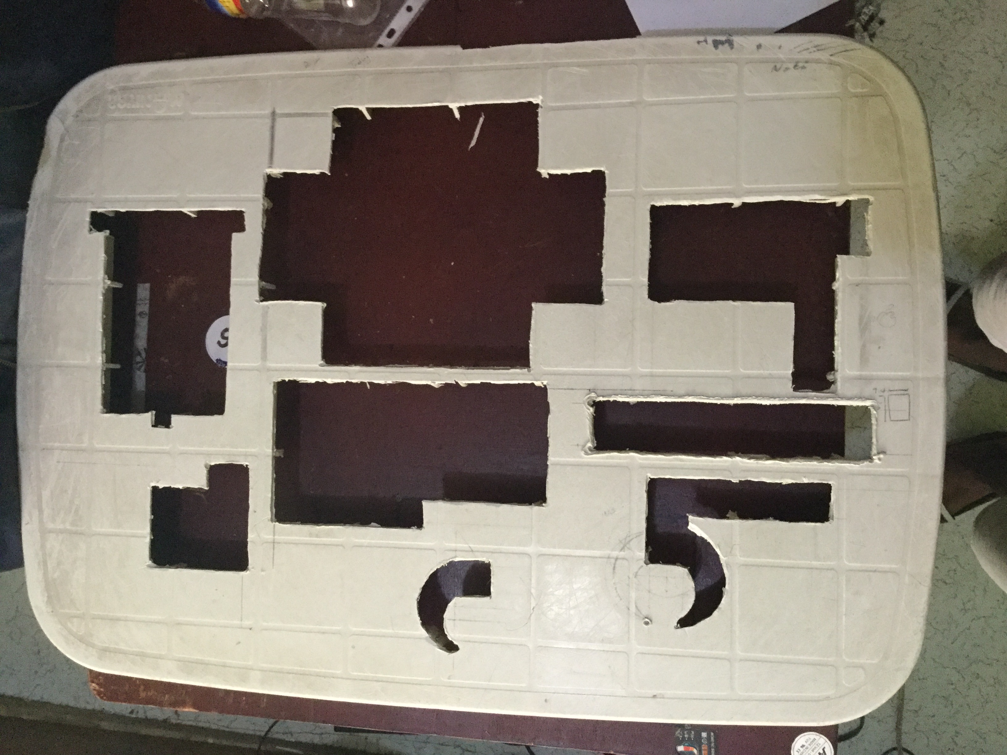
images/photo/IMG_3040.JPG
