Nate-Asmare/Quadruple-robot-build-and-design/images/robo/modules.png

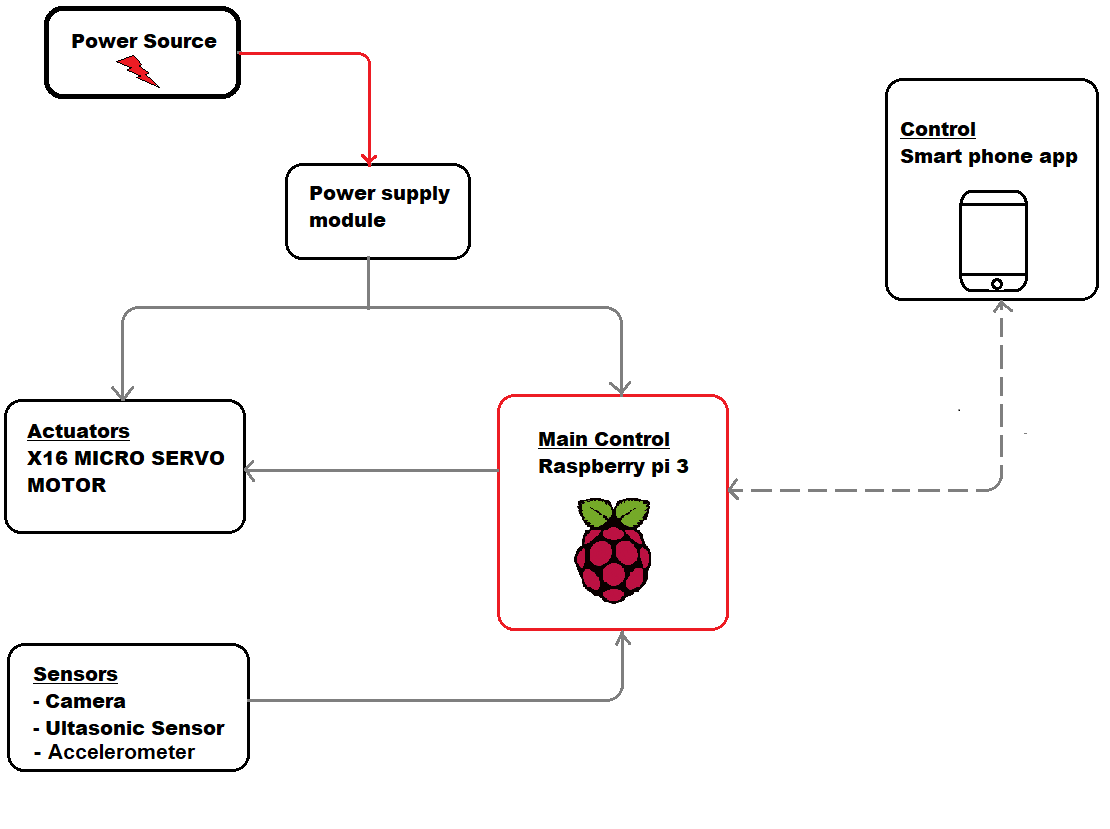
images/robo/modules.png
