Nate-Asmare/Quadruple-robot-build-and-design/images/robo/outline.png

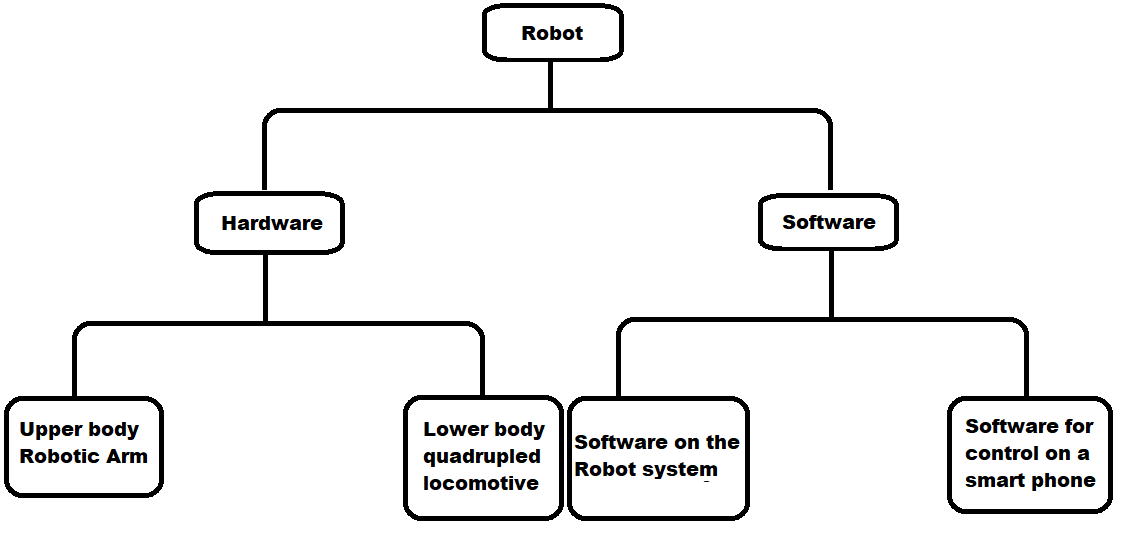
images/robo/outline.png
