Nate-Asmare/Quadruple-robot-build-and-design/images/robo/robo_arm.png

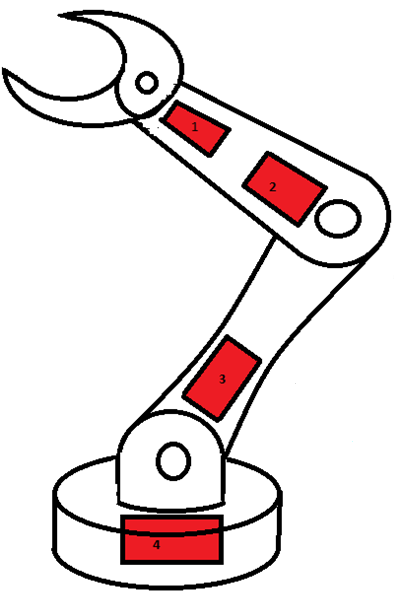
images/robo/robo_arm.png
