Nate-Asmare/Quadruple-robot-build-and-design/images/screen shots/home.png

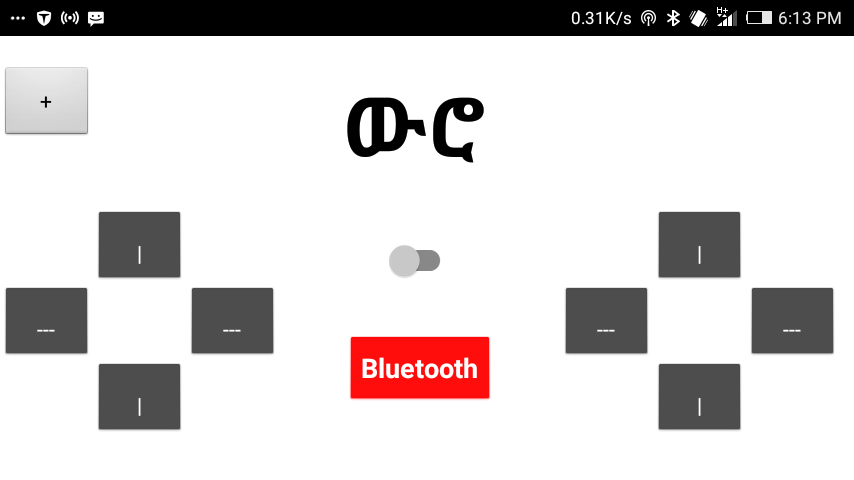
images/screen shots/home.png
