Nate-Asmare/Quadruple-robot-build-and-design/images/screen shots/motion select.png

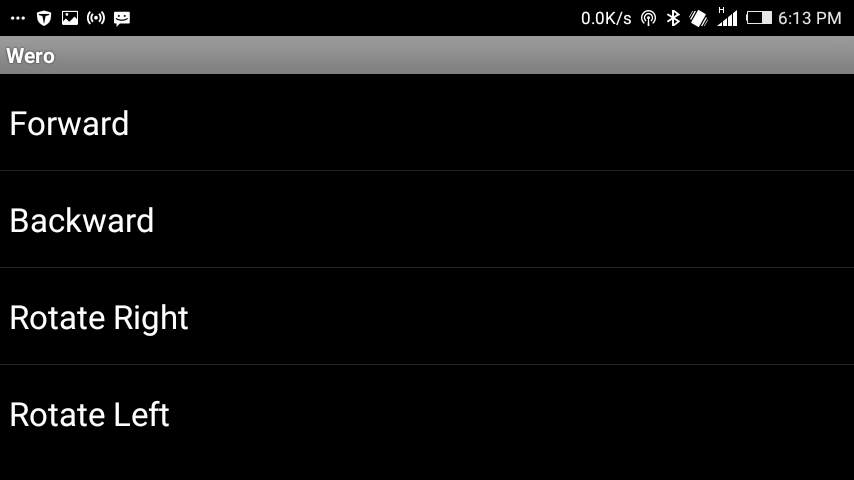
images/screen shots/motion select.png
