Nate-Asmare/Quadruple-robot-build-and-design/images/screen shots/settings.png

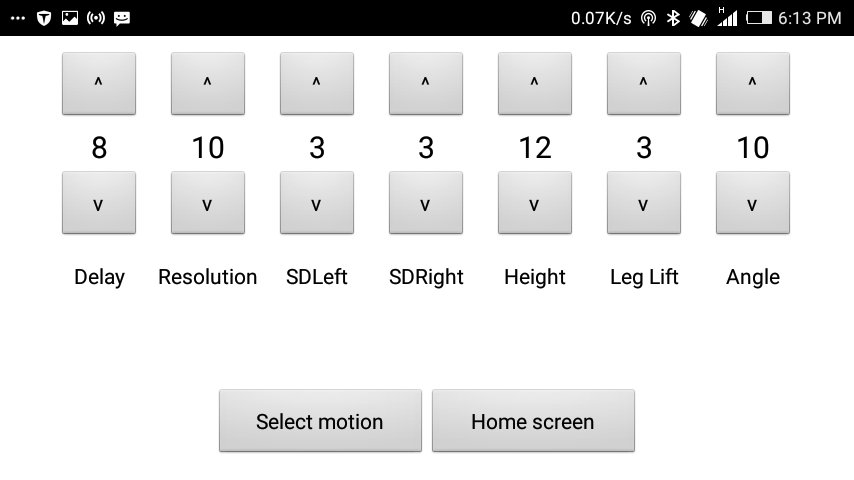
images/screen shots/settings.png
