Nate-Asmare/Quadruple-robot-build-and-design/images/web images/ANYmal.jpg

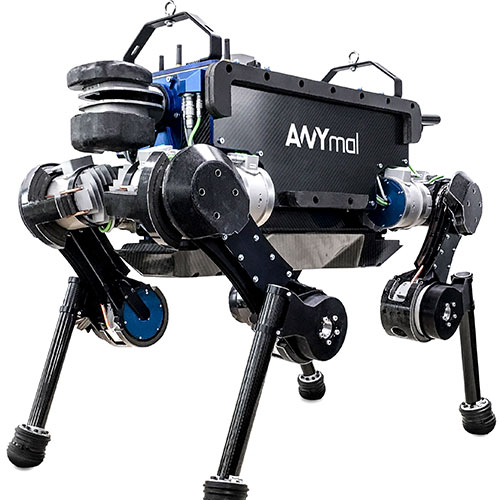
images/web images/ANYmal.jpg
