Nate-Asmare/Quadruple-robot-build-and-design/images/web images/spot mini.jpg

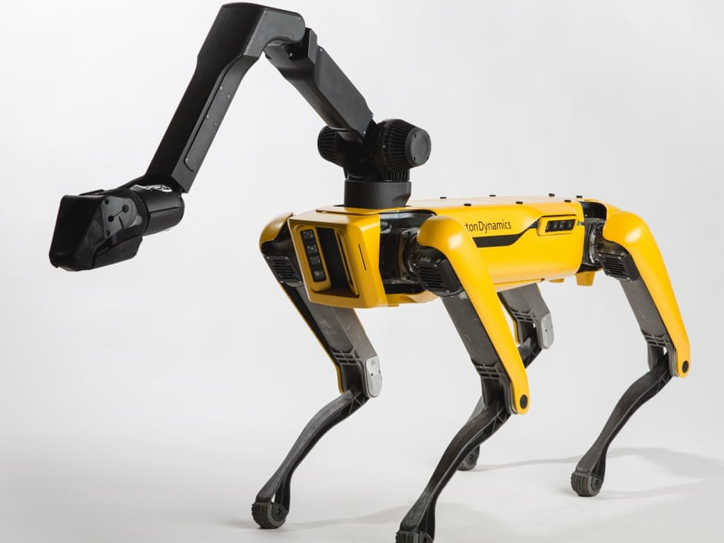
images/web images/spot mini.jpg
