Nate-Asmare/Quadruple-robot-build-and-design/Proteus simulation/pic/sim.png

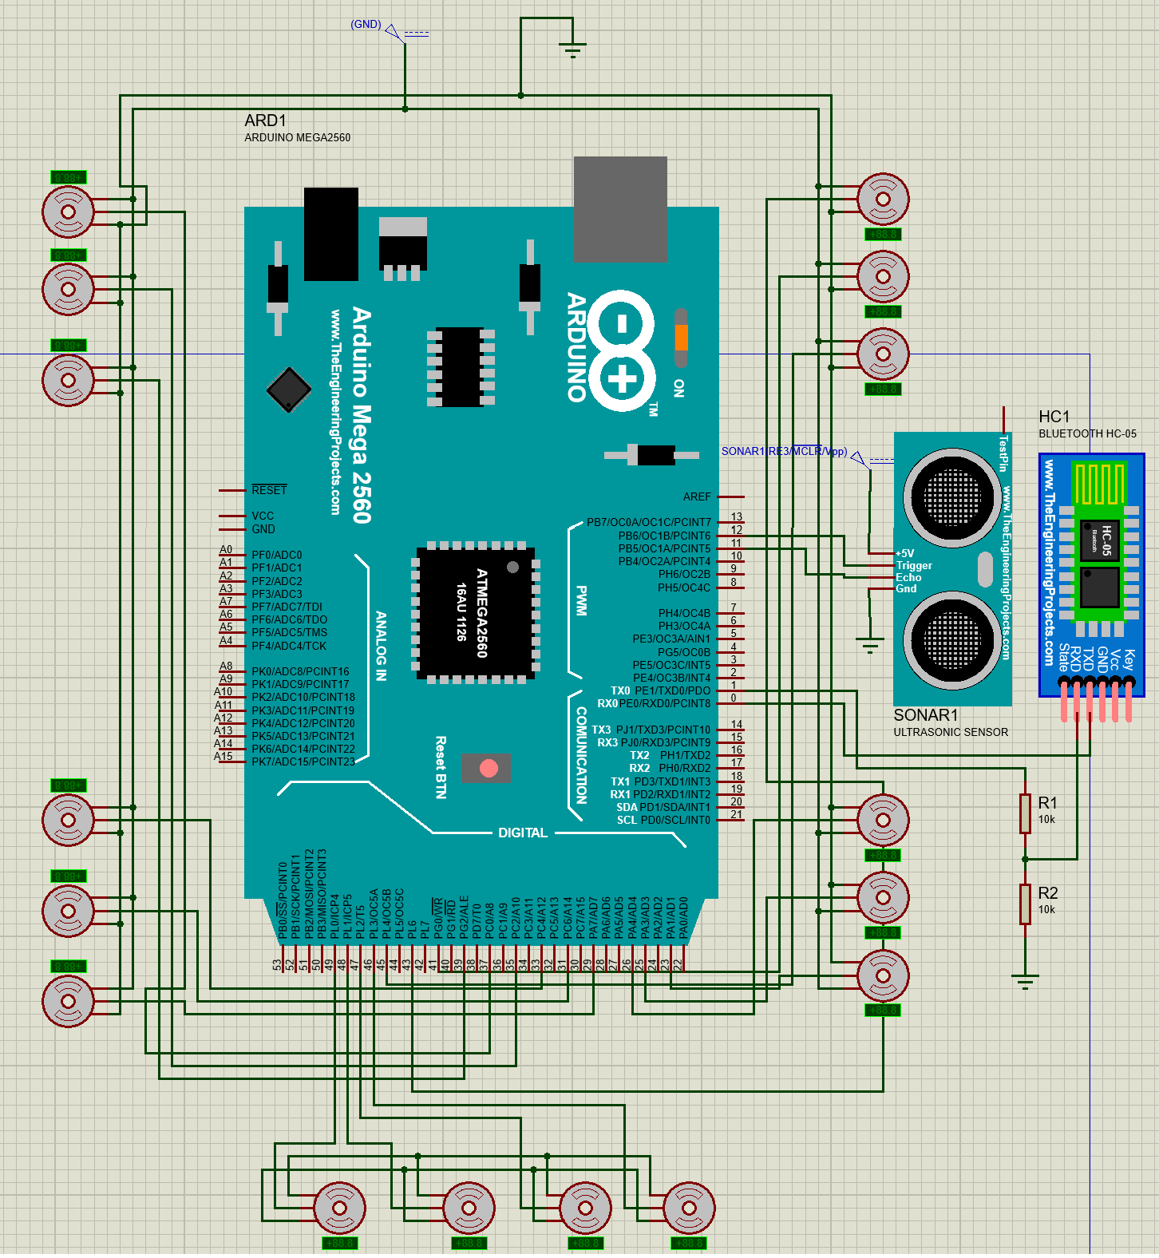
Proteus simulation/pic/sim.png
