Nate-Asmare/Quadruple-robot-build-and-design/Solidwork model/testing/v1.SLDASM

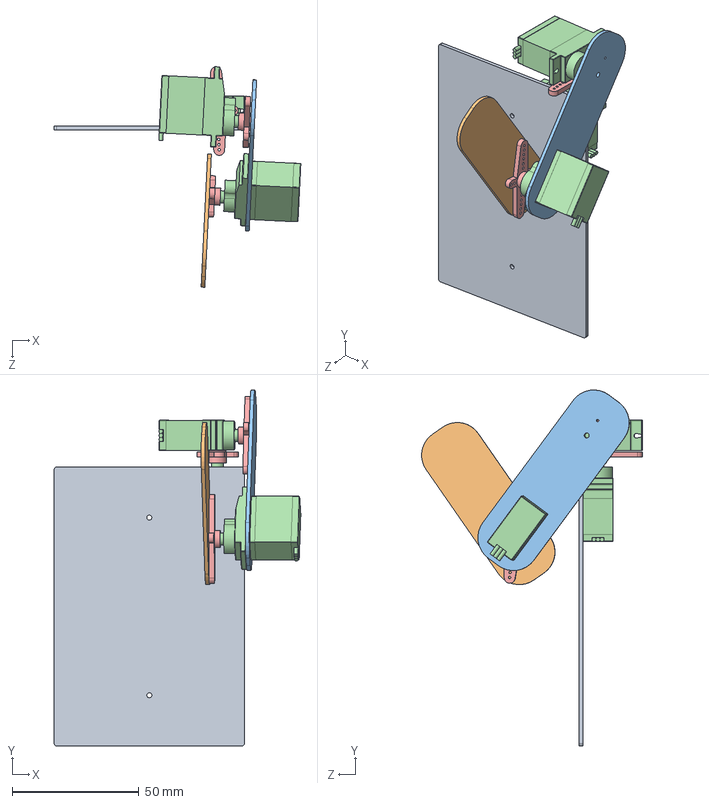
[picture p73: CAD file, 2021-07-18]
Solidwork model/testing/v1.SLDASM
97.2 x 140.3 x 87.0 mm
flatBelly
lowerArm
upperArm
SERVO MG92B x 3
MG90servo_gear x 3
