Nate-Asmare/Quadruple-robot-build-and-design/Solidwork model/upper arm.SLDASM

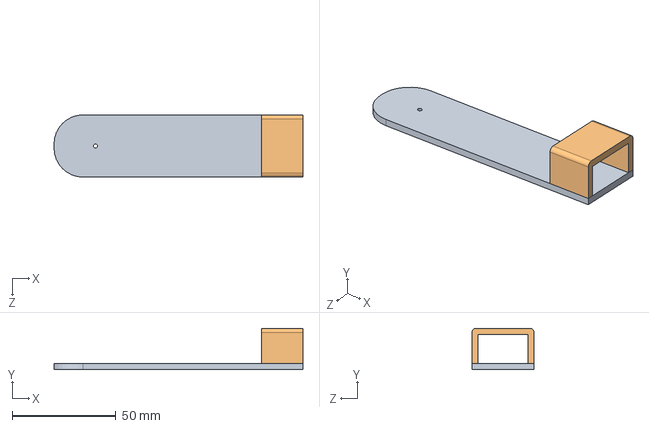
[picture p74: CAD file, 2021-07-18]
Solidwork model/upper arm.SLDASM
120.0 x 20.0 x 30.0 mm
upper arm with out c braket
upper arm c braket
