Nate-Asmare/Quadruple-robot-build-and-design/Solidwork model/body all stack.SLDASM

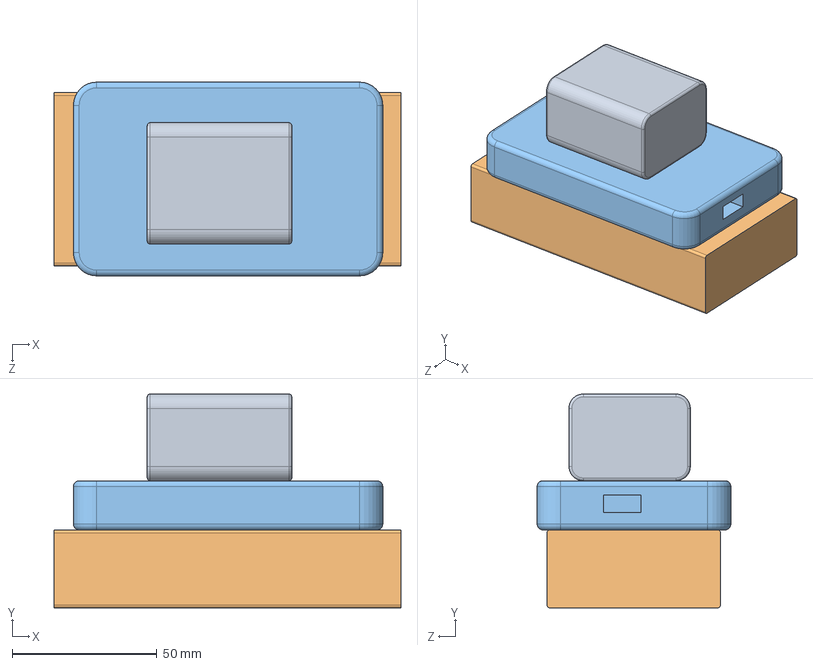
[picture p75: CAD file, 2021-07-18]
Solidwork model/body all stack.SLDASM
120.0 x 74.0 x 67.0 mm
9v battery
arduino with shild
power bank
