Nate-Asmare/Quadruple-robot-build-and-design/Solidwork model/Body enclosure design with internal components.SLDASM

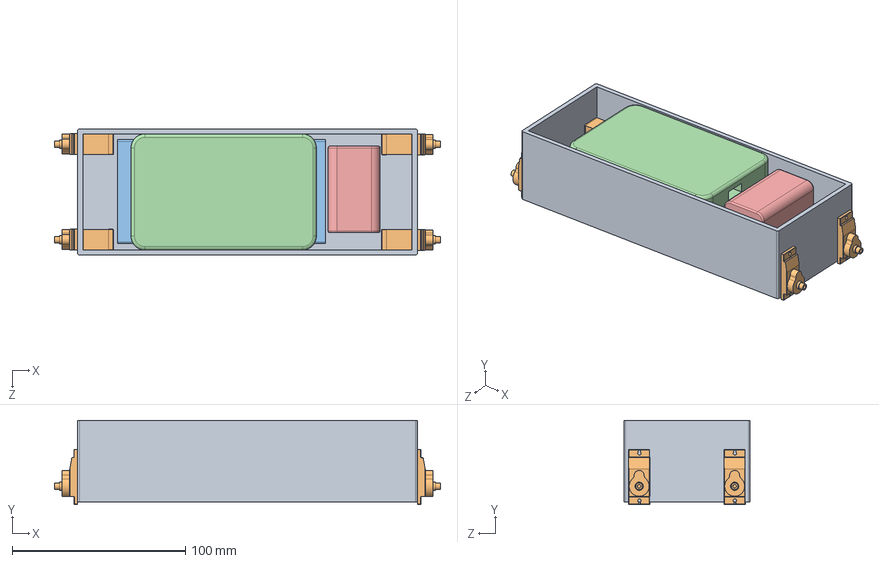
[picture p76: CAD file, 2021-07-18]
Solidwork model/Body enclosure design with internal components.SLDASM
222.8 x 48.5 x 73.0 mm
body encloser v1
SERVO MG92B x 4
arduino with shild
power bank
9v battery
