Nate-Asmare/Quadruple-robot-build-and-design/Solidwork model/leg assembly.SLDASM

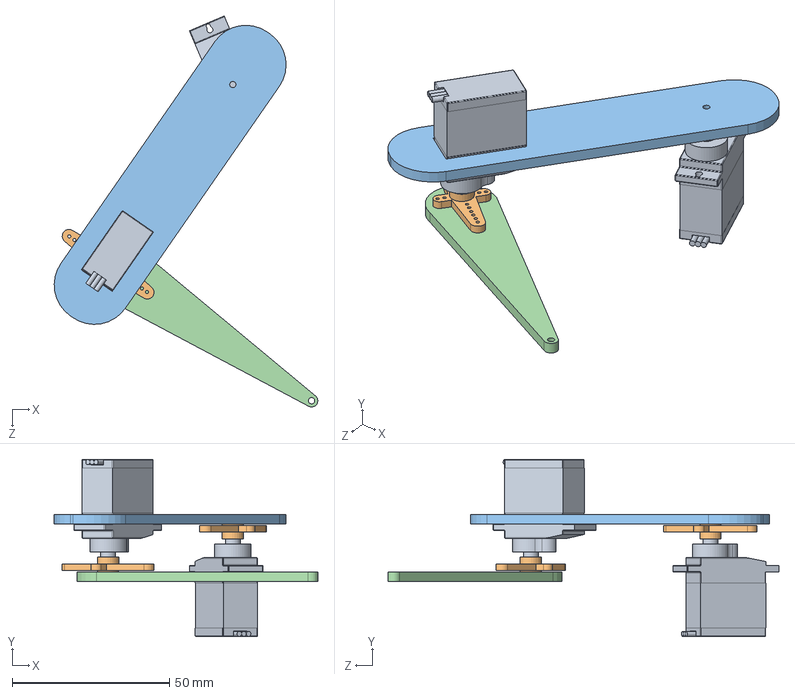
[picture p77: CAD file, 2021-07-18]
Solidwork model/leg assembly.SLDASM
83.9 x 56.4 x 124.5 mm
SERVO MG92B x 2
MG90servo_gear x 2
upper leg section
lower leg section
