Nate-Asmare/Quadruple-robot-build-and-design/Solidwork model/quadrupled locomotive assembly.SLDASM

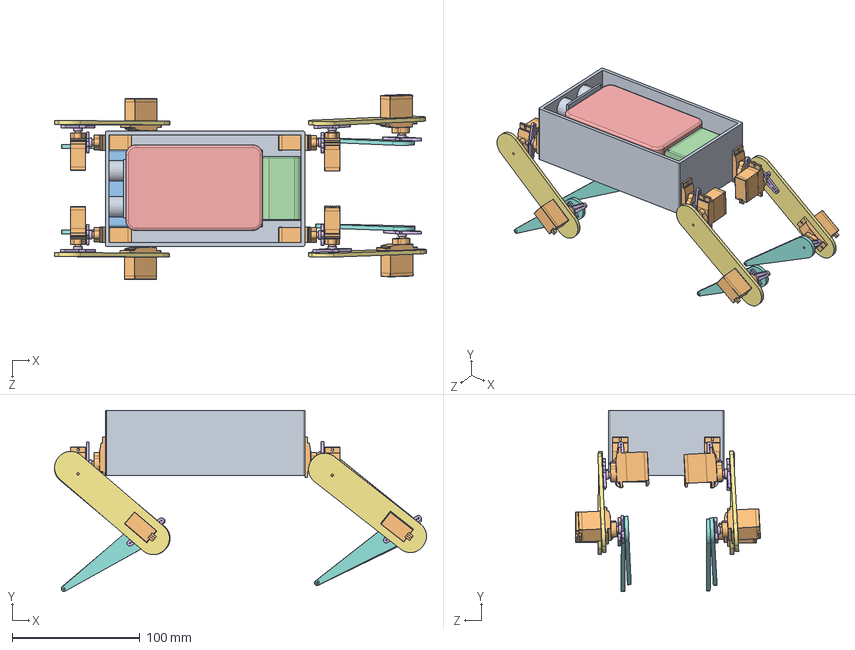
[picture p78: CAD file, 2021-07-18]
Solidwork model/quadrupled locomotive assembly.SLDASM
290.9 x 141.6 x 144.8 mm
Body enclosure design v2
SERVO MG92B x 12
arduino with shild
9v battery
power bank
MG90servo_gear x 12
upper leg section x 4
lower leg section x 4
ultrasonic sensor
