Nate-Asmare/Quadruple-robot-build-and-design/Solidwork model/Body enclosure design v2 including internals.SLDASM

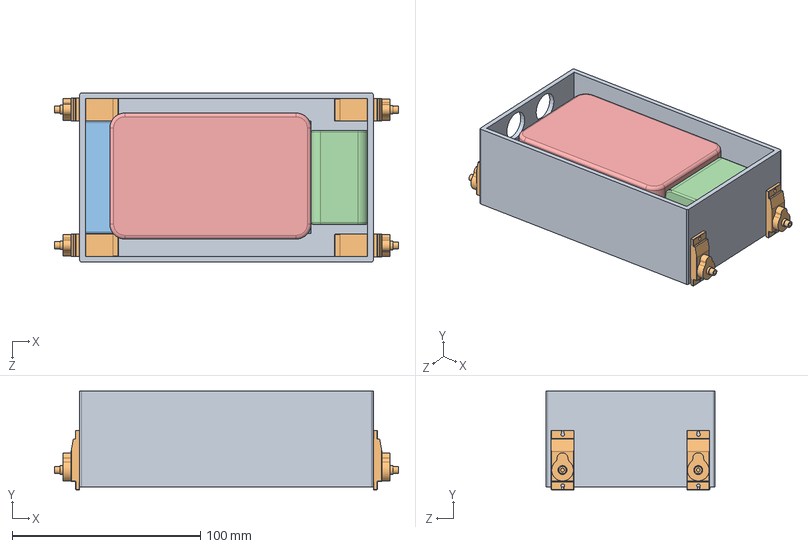
[picture p80: CAD file, 2021-07-18]
Solidwork model/Body enclosure design v2 including internals.SLDASM
182.8 x 52.5 x 90.0 mm
Body enclosure design v2
SERVO MG92B x 4
arduino with shild
9v battery
power bank
