Nate-Asmare/Quadruple-robot-build-and-design/Solidwork model/Body internals arrangement v2.SLDASM

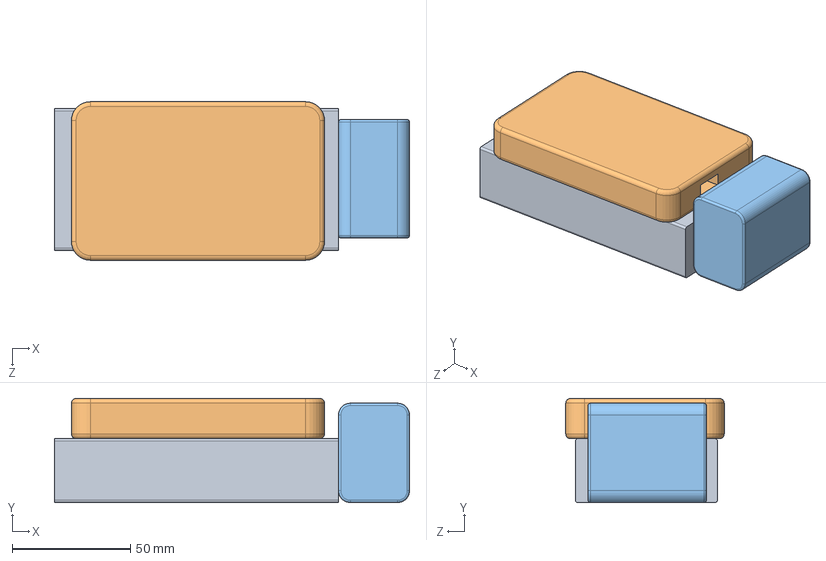
[picture p81: CAD file, 2021-07-18]
Solidwork model/Body internals arrangement v2.SLDASM
150.0 x 44.0 x 67.0 mm
arduino with shild
power bank
9v battery
