Nate-Asmare/Quadruple-robot-build-and-design/Solidwork model/testing/arduino with shild.SLDPRT

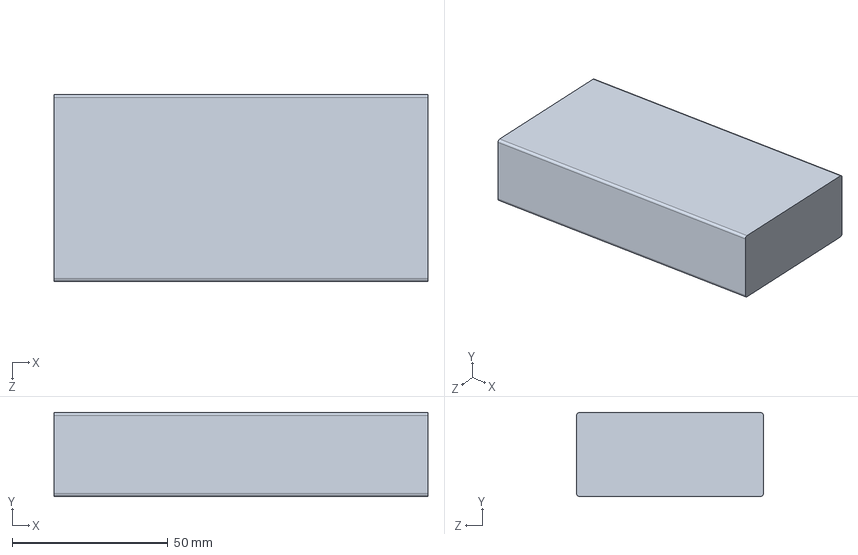
[picture p82: CAD file, 2021-07-18]
Solidwork model/testing/arduino with shild.SLDPRT
120.0 x 27.0 x 60.0 mm
