Nate-Asmare/Quadruple-robot-build-and-design/Solidwork model/9v jack.SLDPRT

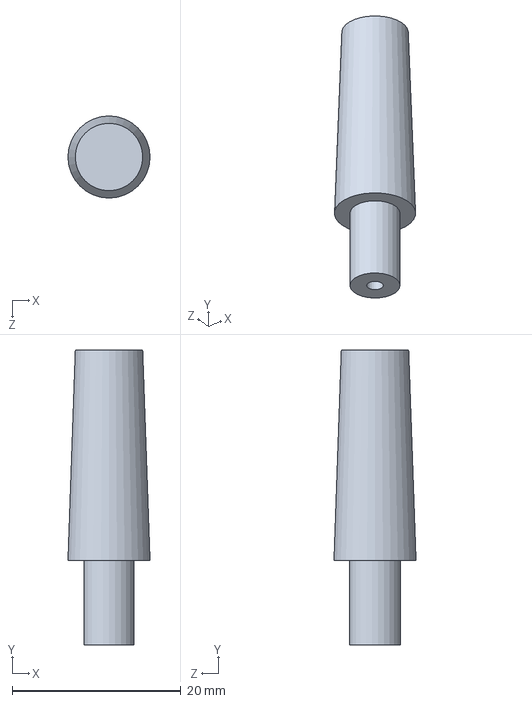
[picture p83: CAD file, 2021-07-18]
Solidwork model/9v jack.SLDPRT
9.75 x 35.0 x 9.75 mm
