Nate-Asmare/Quadruple-robot-build-and-design/Solidwork model/9v battery.SLDPRT

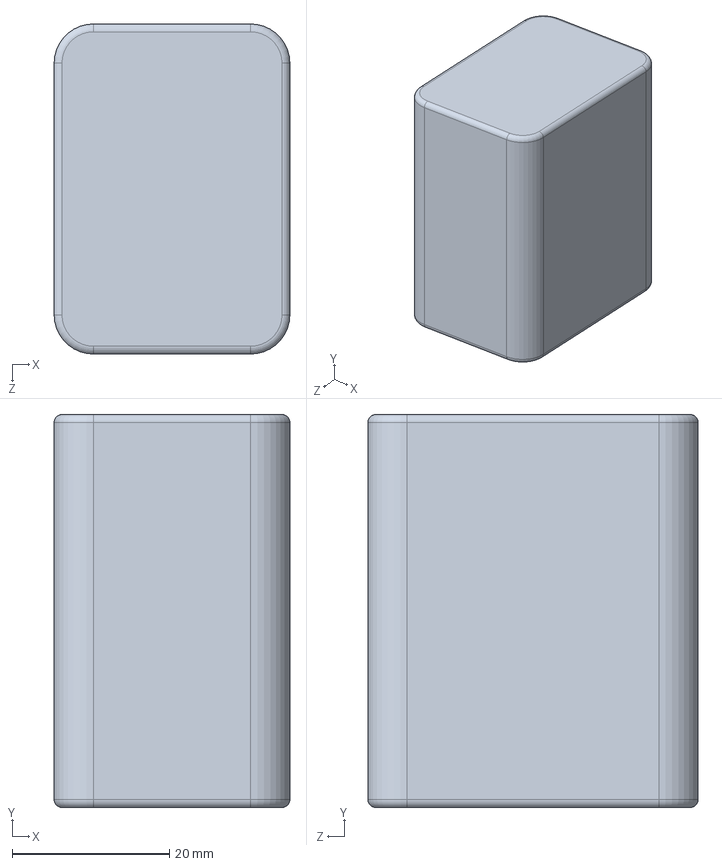
[picture p84: CAD file, 2021-07-18]
Solidwork model/9v battery.SLDPRT
30.0 x 50.0 x 42.0 mm
