Nate-Asmare/Quadruple-robot-build-and-design/Solidwork model/upper arm c braket.SLDPRT

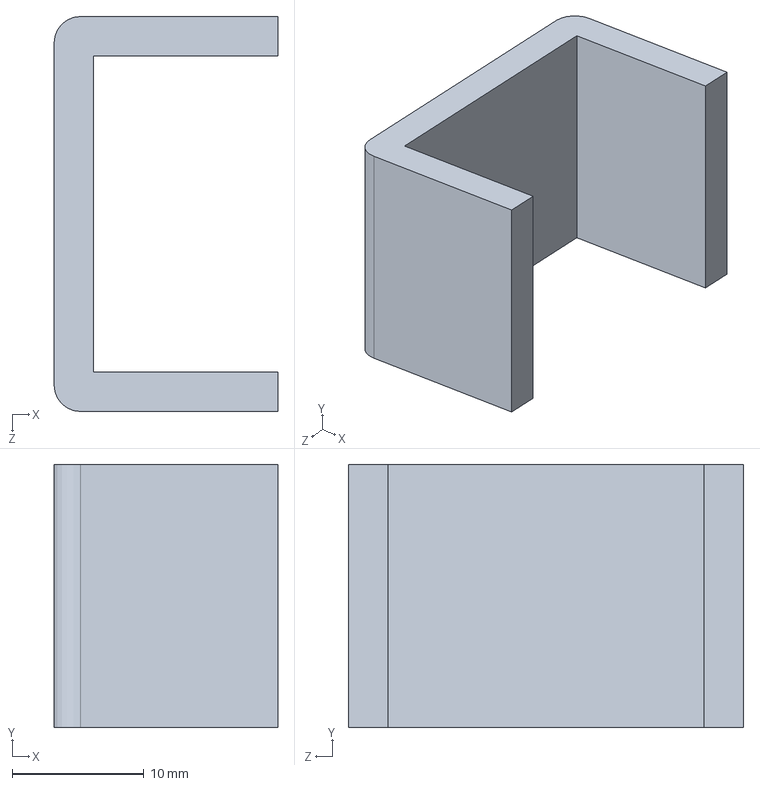
[picture p85: CAD file, 2021-07-18]
Solidwork model/upper arm c braket.SLDPRT
17.0 x 20.0 x 30.0 mm
