Nate-Asmare/Quadruple-robot-build-and-design/Solidwork model/upper arm with out c braket.SLDPRT

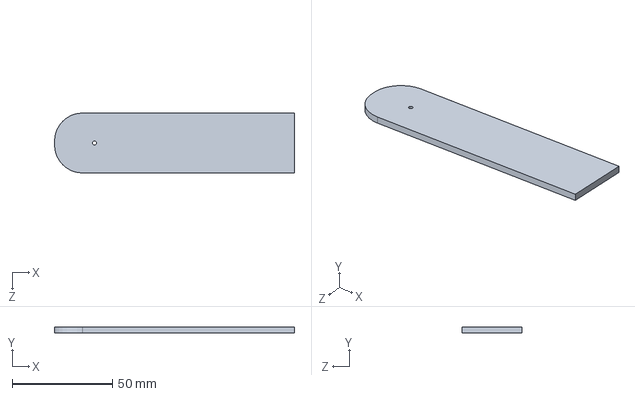
[picture p86: CAD file, 2021-07-18]
Solidwork model/upper arm with out c braket.SLDPRT
120.0 x 3.00 x 30.0 mm
