Nate-Asmare/Quadruple-robot-build-and-design/Solidwork model/body cover.SLDPRT

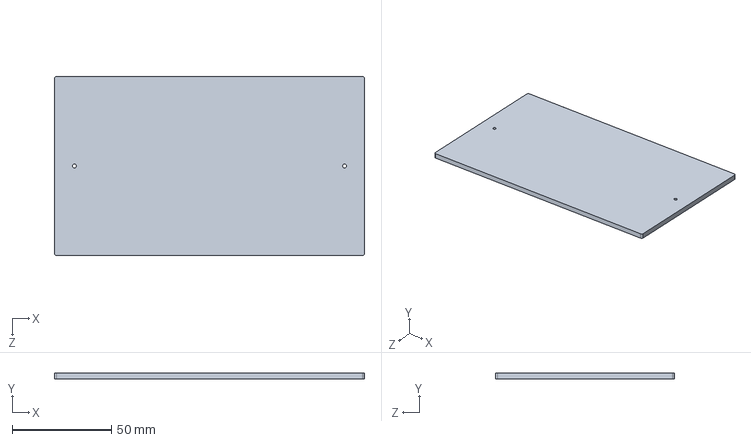
[picture p87: CAD file, 2021-07-18]
Solidwork model/body cover.SLDPRT
156.0 x 3.00 x 90.0 mm
