Nate-Asmare/Quadruple-robot-build-and-design/Solidwork model/lower arm.SLDPRT

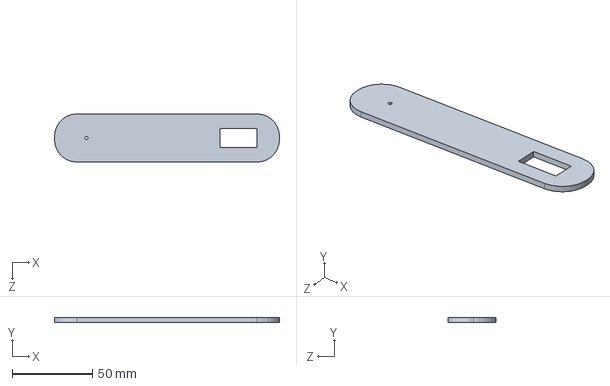
[picture p88: CAD file, 2021-07-18]
Solidwork model/lower arm.SLDPRT
140.0 x 3.00 x 30.0 mm
