Nate-Asmare/Quadruple-robot-build-and-design/Solidwork model/power bank.SLDPRT

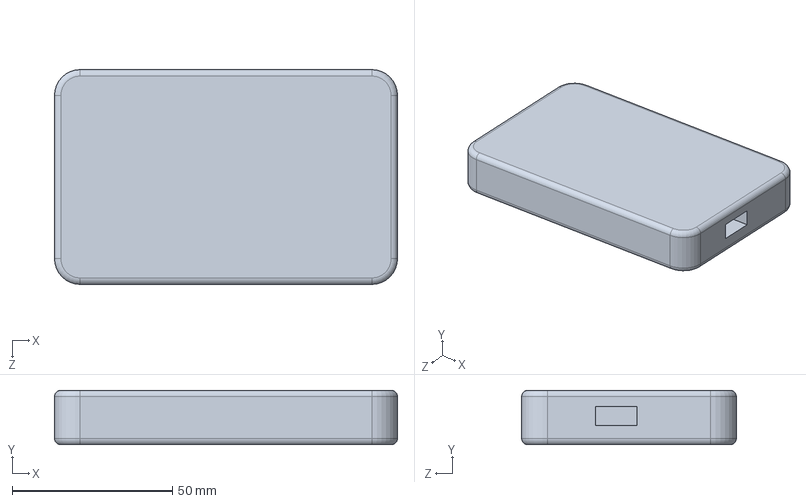
[picture p89: CAD file, 2021-07-18]
Solidwork model/power bank.SLDPRT
107.0 x 17.0 x 67.0 mm
