Nate-Asmare/Quadruple-robot-build-and-design/Solidwork model/endeffector plan 1.SLDPRT

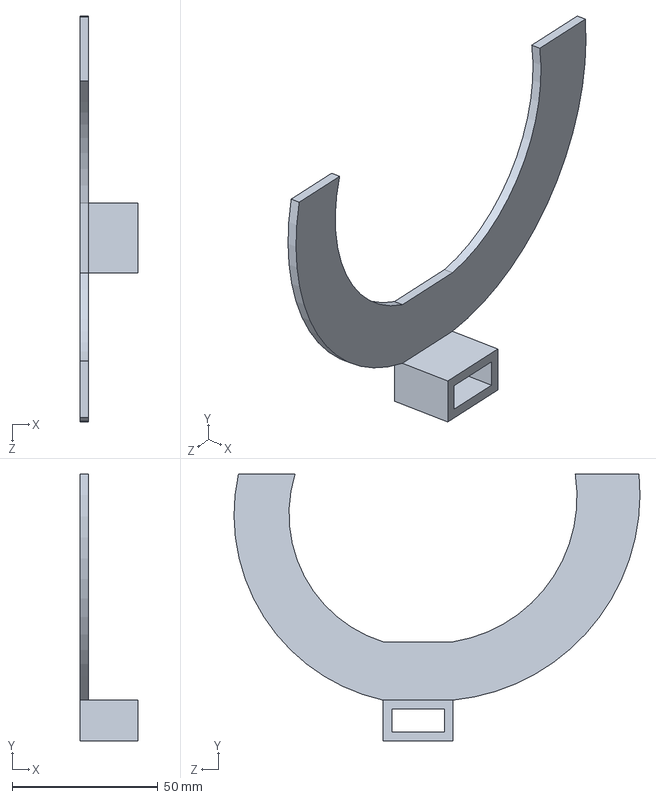
[picture p90: CAD file, 2021-07-18]
Solidwork model/endeffector plan 1.SLDPRT
20.0 x 91.5 x 139.2 mm
