Nate-Asmare/Quadruple-robot-build-and-design/Solidwork model/ultrasonic sensor.SLDPRT

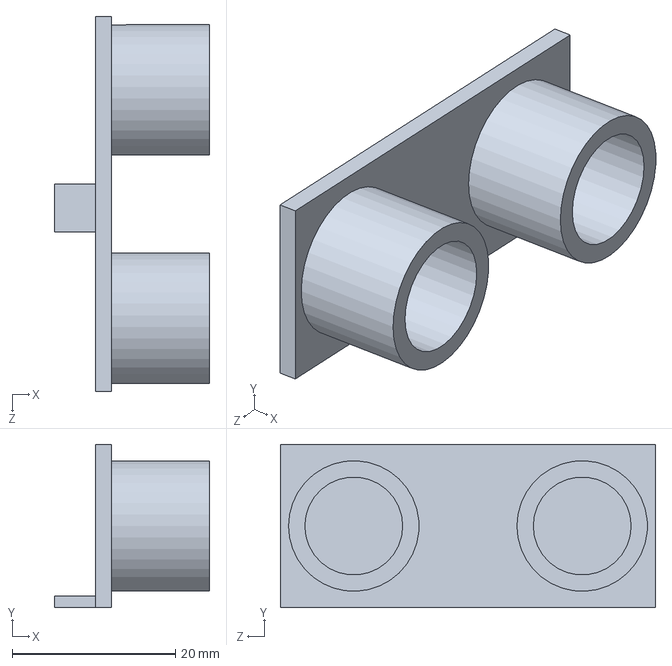
[picture p91: CAD file, 2021-07-18]
Solidwork model/ultrasonic sensor.SLDPRT
19.0 x 20.0 x 46.0 mm
