Nate-Asmare/Quadruple-robot-build-and-design/Solidwork model/body encloser v1.SLDPRT

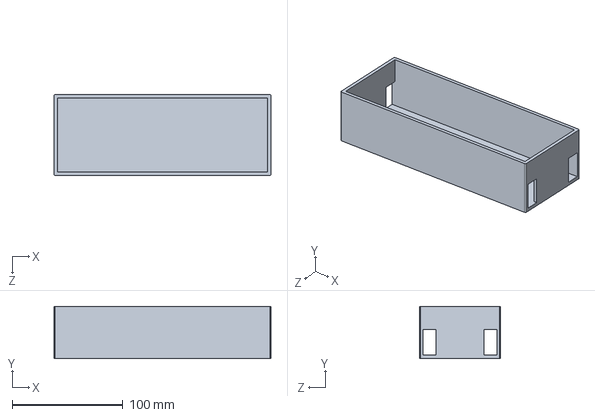
[picture p92: CAD file, 2021-07-18]
Solidwork model/body encloser v1.SLDPRT
196.0 x 47.0 x 73.0 mm
