Nate-Asmare/Quadruple-robot-build-and-design/Solidwork model/cup.SLDPRT

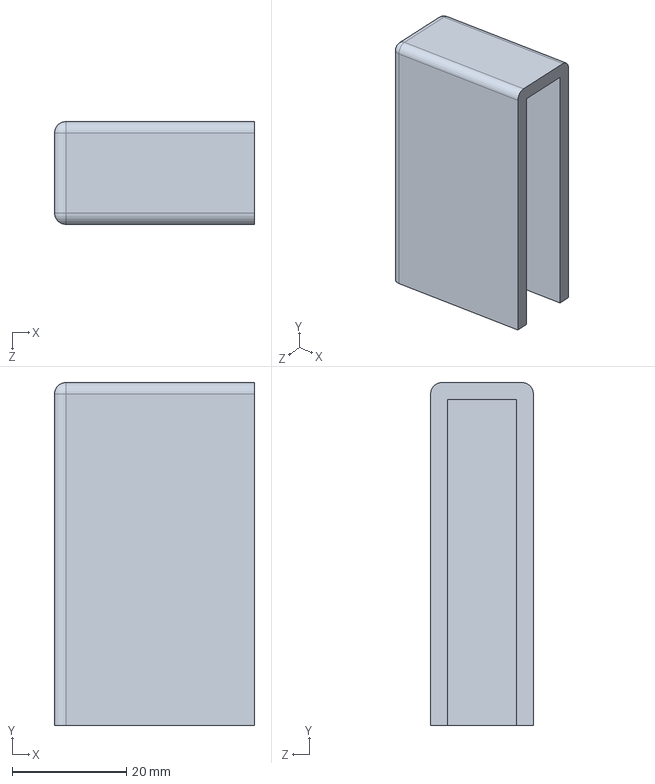
[picture p93: CAD file, 2021-07-18]
Solidwork model/cup.SLDPRT
35.0 x 60.0 x 18.0 mm
