Nate-Asmare/Quadruple-robot-build-and-design/Solidwork model/lower leg section.SLDPRT

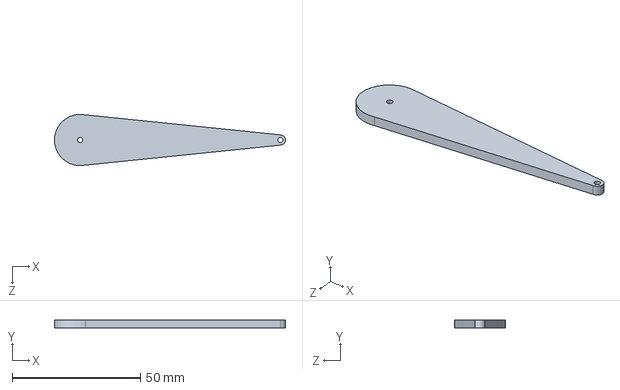
[picture p94: CAD file, 2021-07-18]
Solidwork model/lower leg section.SLDPRT
89.9 x 3.00 x 20.0 mm
