Nate-Asmare/Quadruple-robot-build-and-design/Solidwork model/upper leg section.SLDPRT

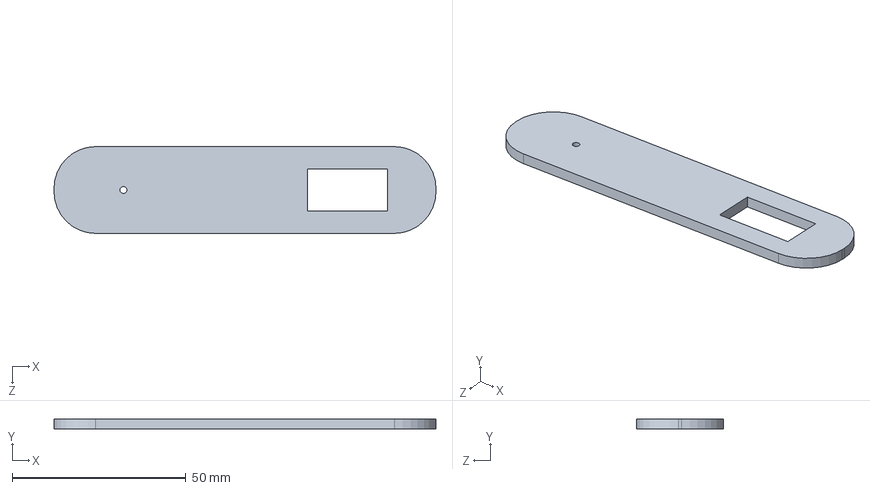
[picture p95: CAD file, 2021-07-18]
Solidwork model/upper leg section.SLDPRT
110.0 x 3.00 x 25.0 mm
