Nate-Asmare/Quadruple-robot-build-and-design/Solidwork model/Body enclosure design v2.SLDPRT

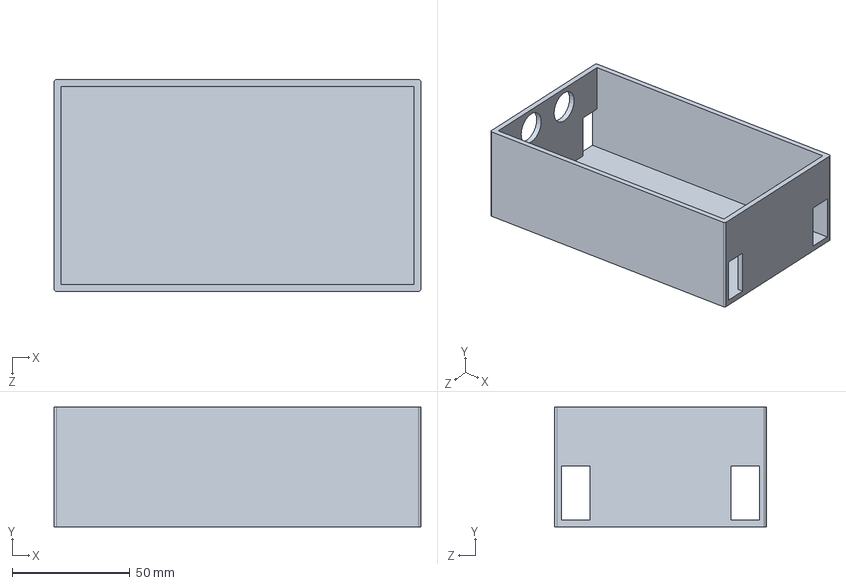
[picture p96: CAD file, 2021-07-18]
Solidwork model/Body enclosure design v2.SLDPRT
156.0 x 51.0 x 90.0 mm
