Nate-Asmare/Quadruple-robot-build-and-design/(list of files, cad)

Other CAD files:
Solidwork model/drawings/9v battery.SLDDRW
Solidwork model/drawings/Body enclosure design v2.SLDDRW
Solidwork model/drawings/arduino with shild.SLDDRW
Solidwork model/drawings/full robot different view.SLDDRW
Solidwork model/drawings/lower leg section.SLDDRW
Solidwork model/drawings/power bank.SLDDRW
Solidwork model/drawings/quadrupled locomotive assembly.SLDDRW
Solidwork model/drawings/ultrasonic sensor.SLDDRW
Solidwork model/drawings/upper arm.SLDDRW
Solidwork model/drawings/upper leg section.SLDDRW
Solidwork model/leg assembly.SLDDRW
Solidwork model/lower arm.SLDDRW
Solidwork model/upper leg section.SLDDRW
