Nate-Asmare/Quadruple-robot-build-and-design/images/diagrams and sketches/building1.png

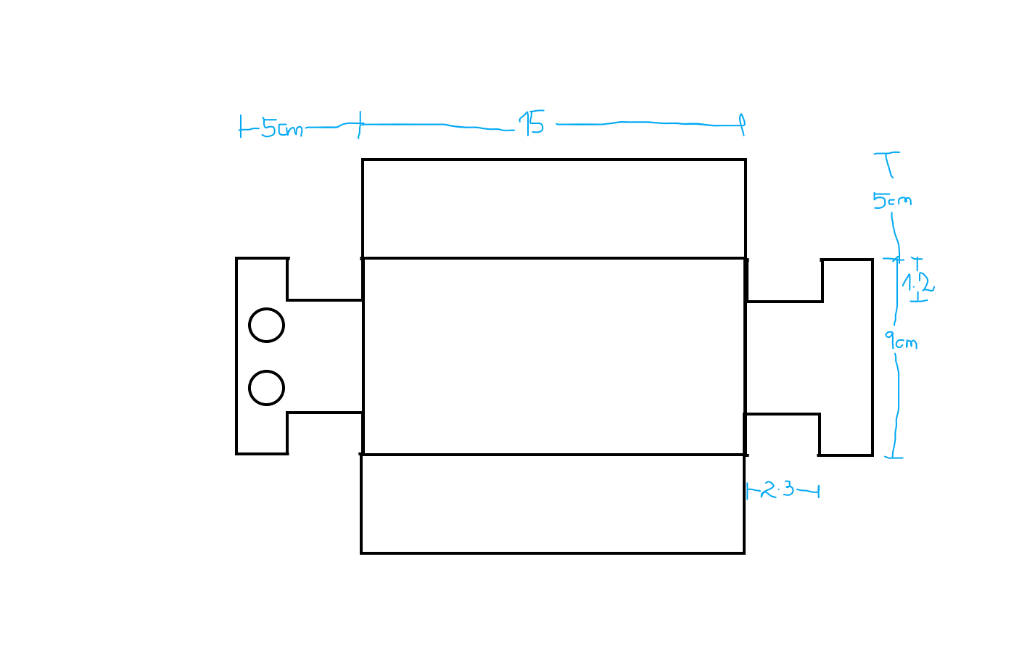
images/diagrams and sketches/building1.png
