Nate-Asmare/Quadruple-robot-build-and-design/(list of files, drawings)

Other design files:
Proteus simulation/wero.pdsprj
